hoeken/brineomatic/README.md

This is the hardware design repository for Brineomatic.

For detailed documentation, please visit the [Brineomatic documentation](https://brineomatic.com).
