hoeken/brineomatic/TODO.md

# Rev D

* github action: https://github.com/alphaseneca/kiforge

* component placement
* routing
* silkscreen
* drc checks
* jlc bom check
* place order
