hoeken/brineomatic/(threads)

Thread 1 (2025-09-27):

Hardware alternative. Can`t find the firmware.

pedrogc2, 2025-09-27:
Interesting project. I am working on something similar for myself using the board KC868-A4 which gives most of the functionalities of this hardware and is a cheap Home automation/development board available online. It may be a good alternative instead of develop a specific PCB.
I couldn`t find the firmware code available on this project, is it also opensource?

pedrogc2, 2025-10-02:
Hi,
Thanks to point me to the firmware file and comment on my PCB.
I tried to install the firmware on my board but I was not successful. I am not familiar with PlataformIO so I may be doing something wrong.
First issue was the rpm install that point several vulnerabilities, including 2 critical and uses many deprecated repositories, not sure if it is causing any problem or not. My terminal output attached.
I went forward and install PlataformIO but I had error to compile the file and upload to the board. print attached.

[npm install.txt](https://github.com/user-attachments/files/22653962/npm.install.txt)
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

hoeken, 2025-10-02:
So the main issue here is that ```gulp``` didnt seem to install correctly.  I haven't tried a fresh install of the dev environment in a while, so its possible something has broken.  Gulp is a bit old too, so its possible the build needs to be updated to something more modern.

During the compile process, ```extra_script.py``` is called.  This basically just calls the command ```gulp``` which takes all the html, css, images, etc and compiles it into a single string and writes that to the index.html.gz.h file.  Since gulp isnt working, it can't find that file and so it fails.

Try running gulp from the command line and see what happens.

Once you get that running, the second problem is that you're compiling for the "SENDIT_REV_A" target.  If you want to write for a custom board, you will need to add it to the platformio.ini file and then choose it from the dropdown at the bottom of the window.

If you are interested in helping with development, I'm about to do a new prototype run of the Brineomatic boards and I will have an extra board I could ship to you.
