hoeken/brineomatic/schematics/Brineomatic Rev C1.pdf

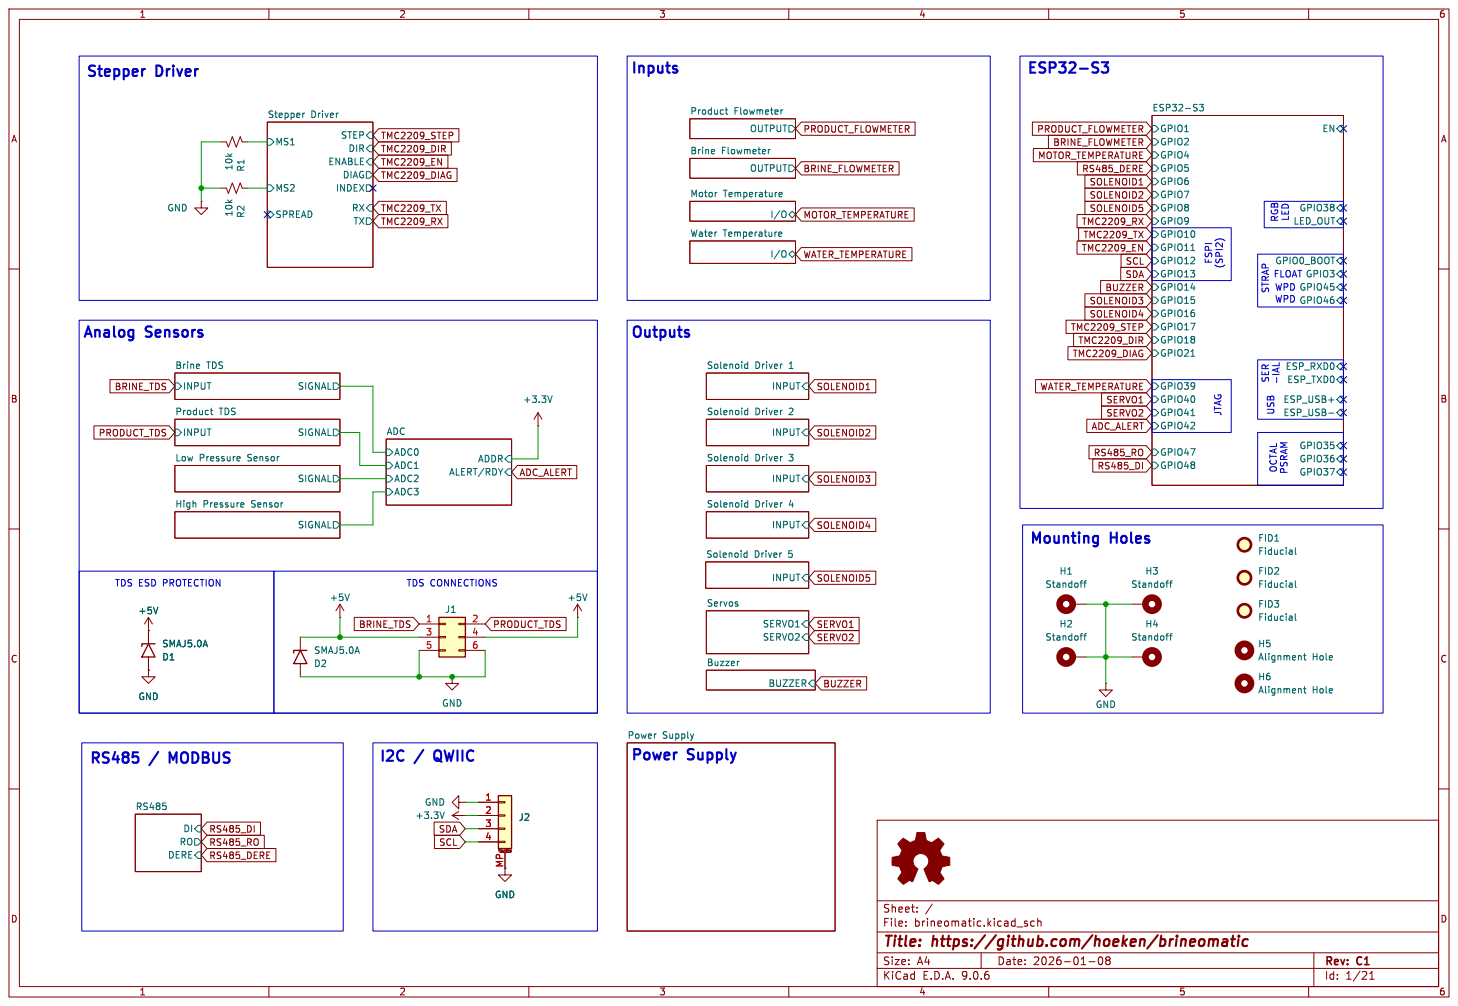
[picture p1: page 1]

SIGNAL High Pressure Sensor

File: brineomatic.kicad_sch Sheet: /
Id: 1/21 Title: https://github.com/hoeken/brineomatic

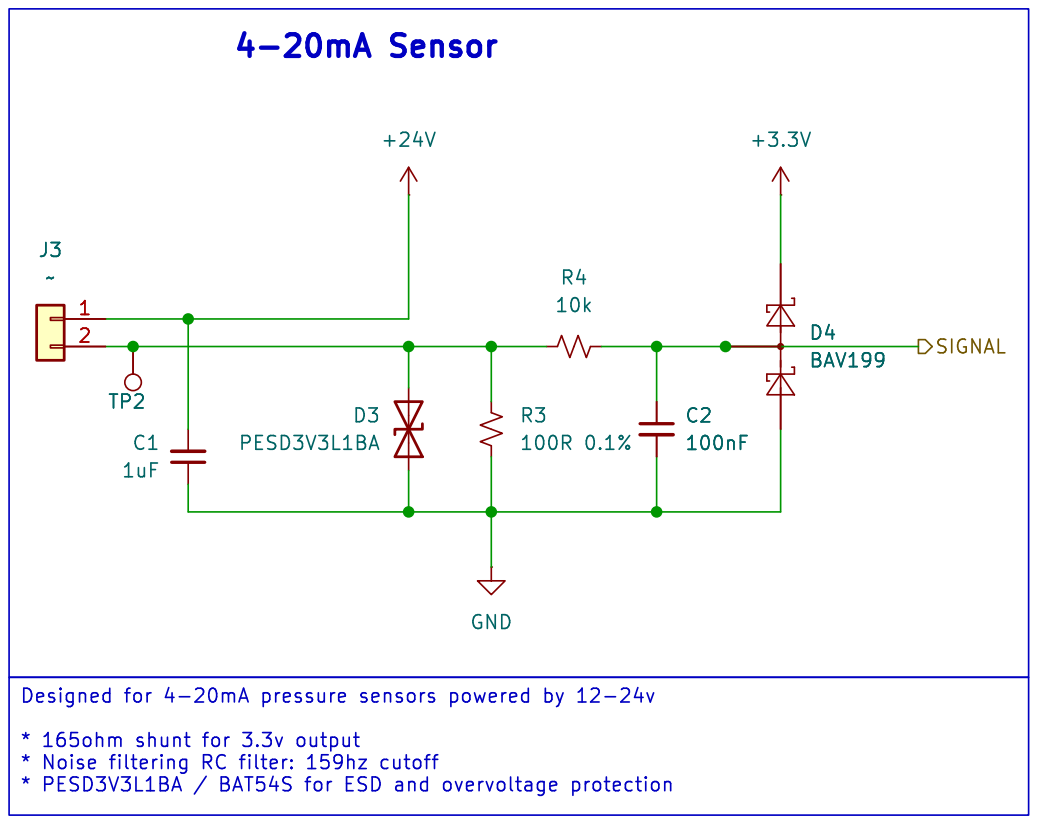
[picture p2: page 2]

Id: 2/21 Title: https://github.com/hoeken/brineomatic

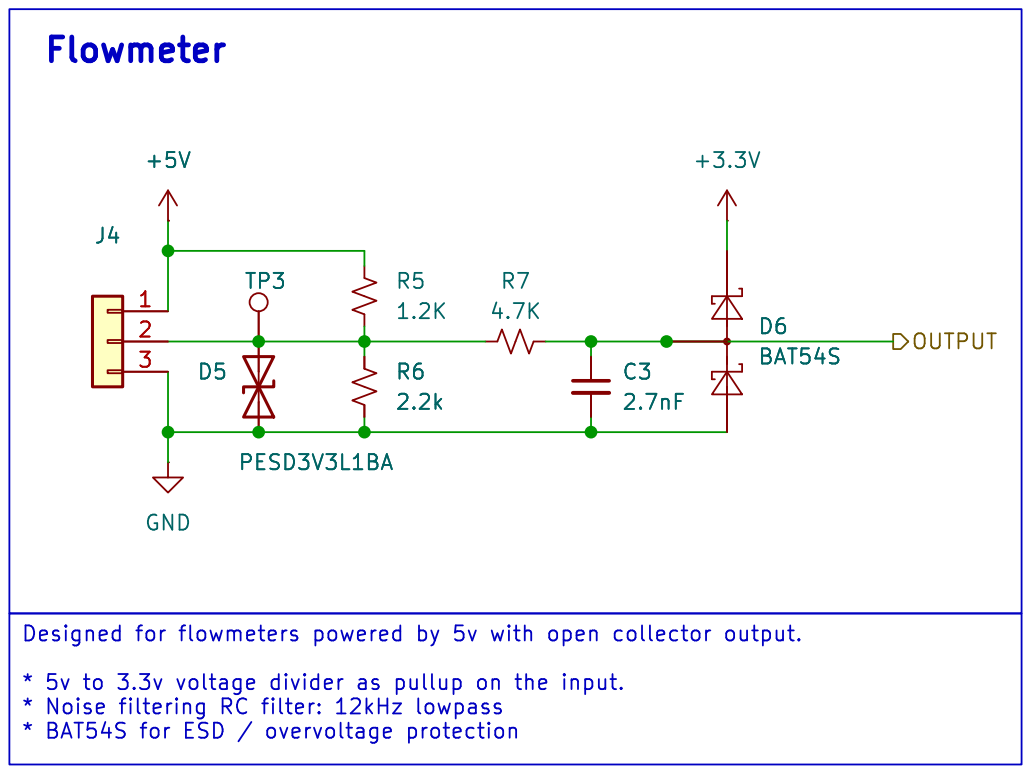
[picture p3: page 3]

Id: 3/21 Title: https://github.com/hoeken/brineomatic

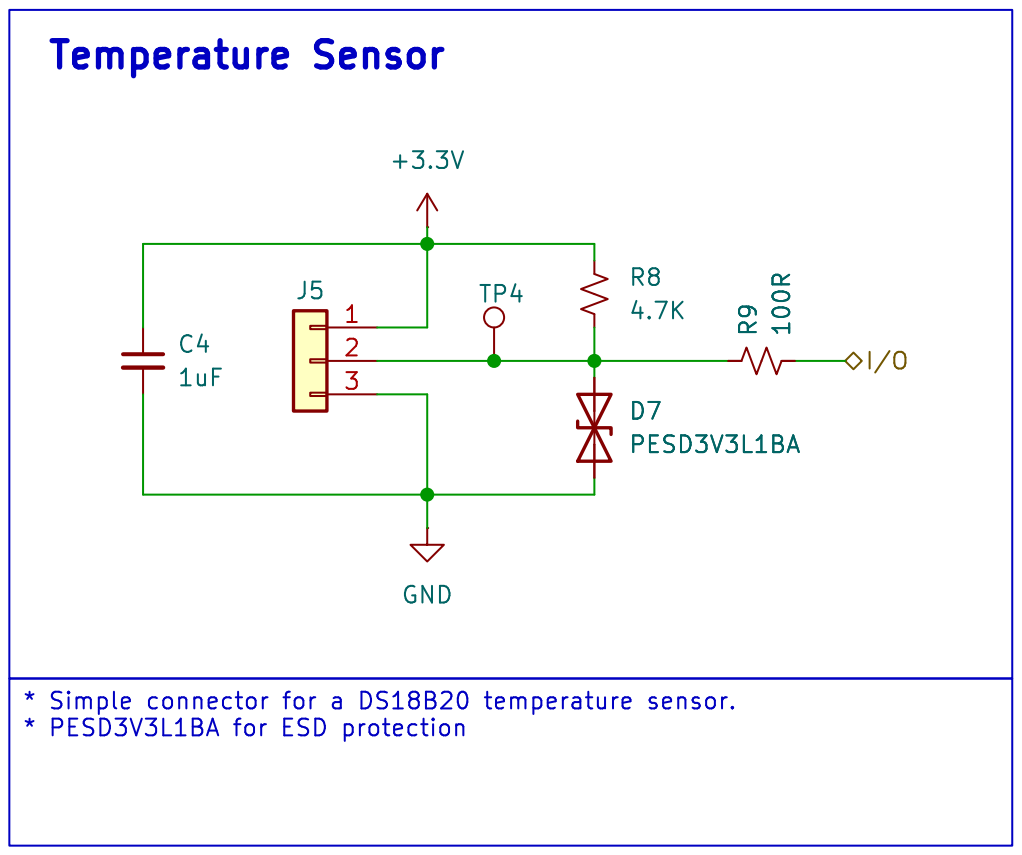
[picture p4: page 4]

Id: 4/21 Title: https://github.com/hoeken/brineomatic

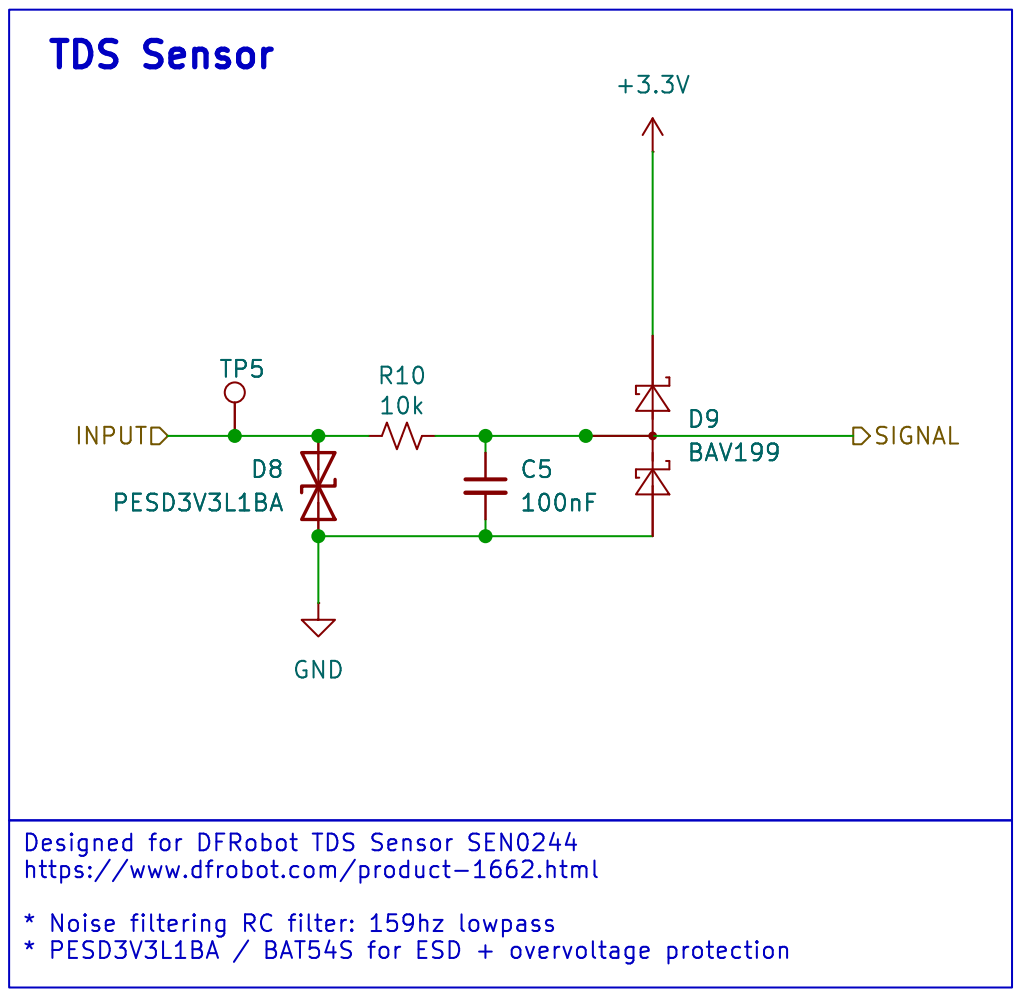
[picture p5: page 5]

Id: 5/21 Title: https://github.com/hoeken/brineomatic

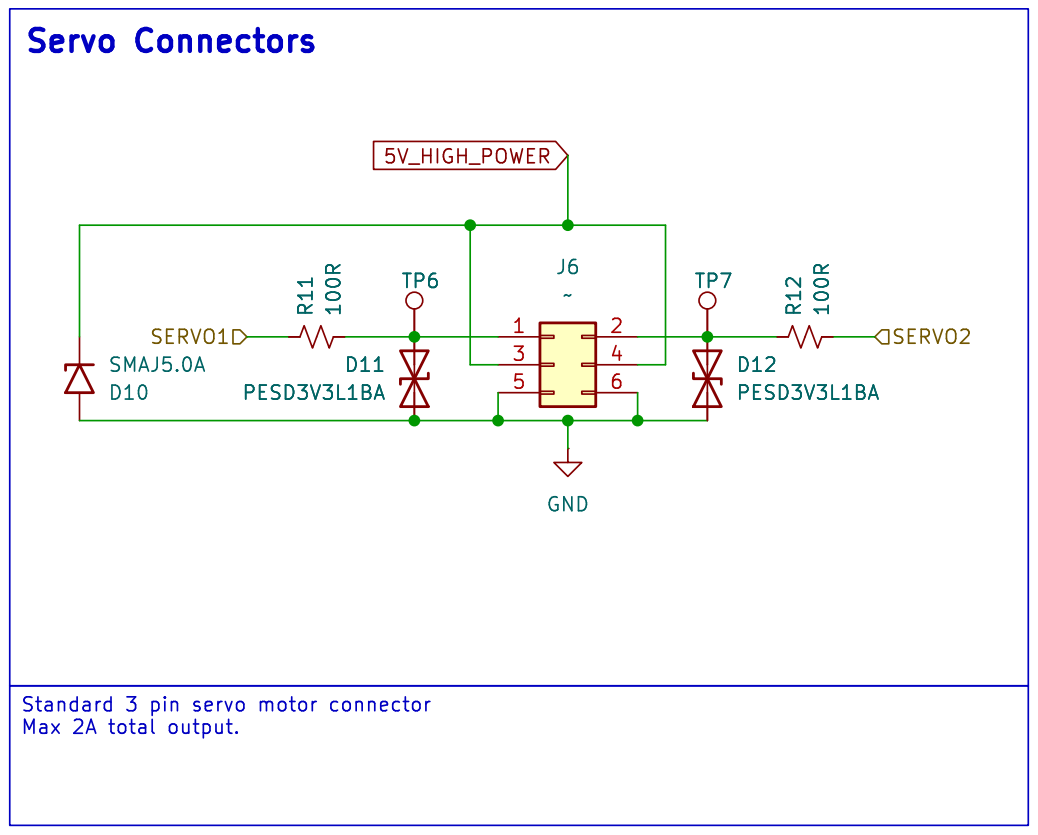
[picture p6: page 6]

Standard 3 pin servo motor connector Max 2A total output. Servo Connectors
File: servo.kicad_sch Sheet: /Servos/ R12 100R

Id: 6/21 Title: https://github.com/hoeken/brineomatic

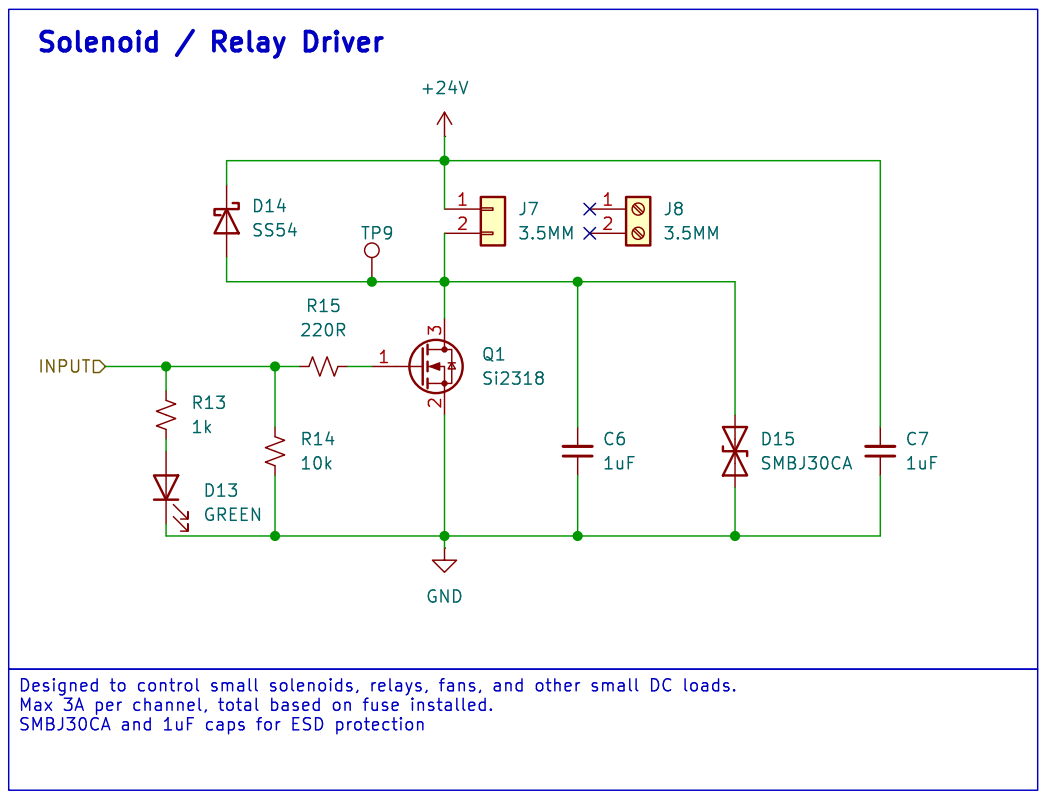
[picture p7: page 7]

Id: 7/21 Title: https://github.com/hoeken/brineomatic

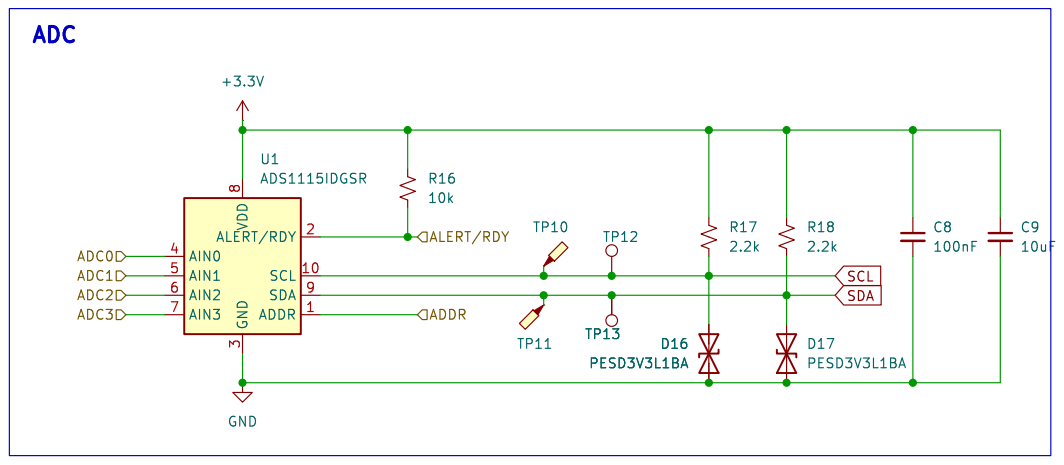
[picture p8: page 8]

3 ALERT/RDY 2 SCL 10 SDA 9 ADDR 1 U1ADS1115IDGSR

Id: 8/21 Title: https://github.com/hoeken/brineomatic

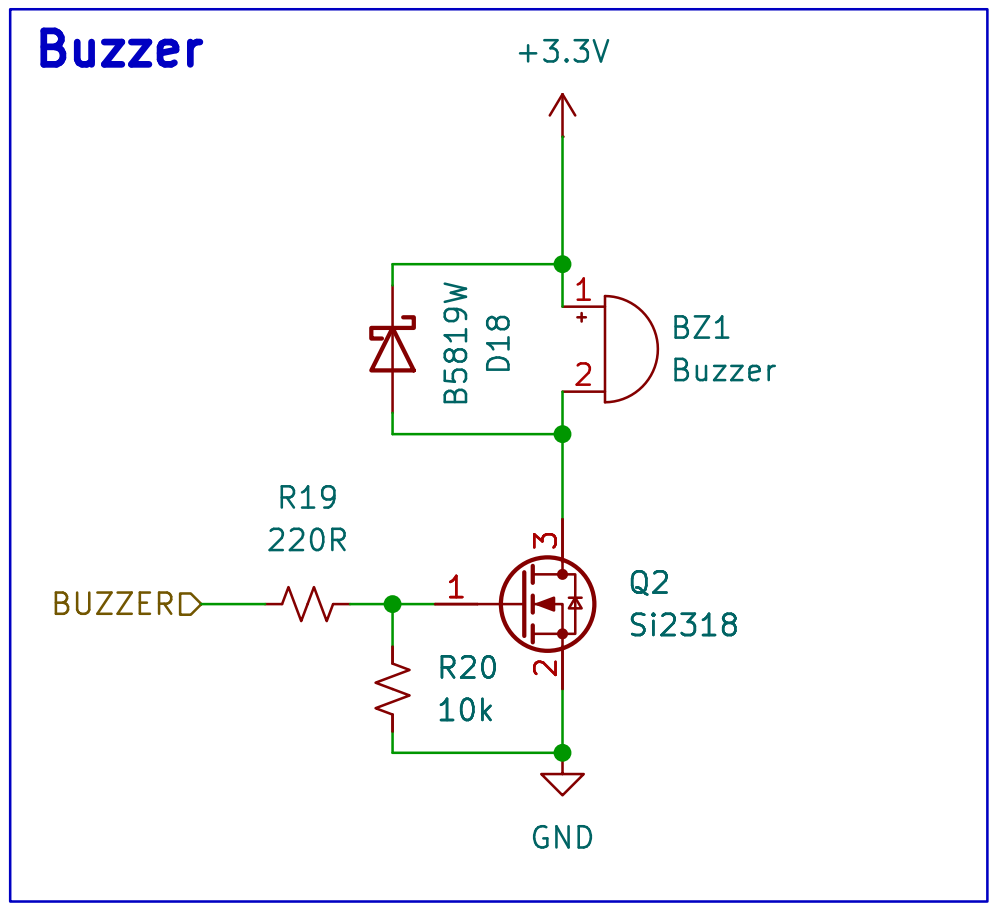
[picture p9: page 9]

File: piezo.kicad_sch Sheet: /Buzzer/ R20

Id: 9/21 Title: https://github.com/hoeken/brineomatic

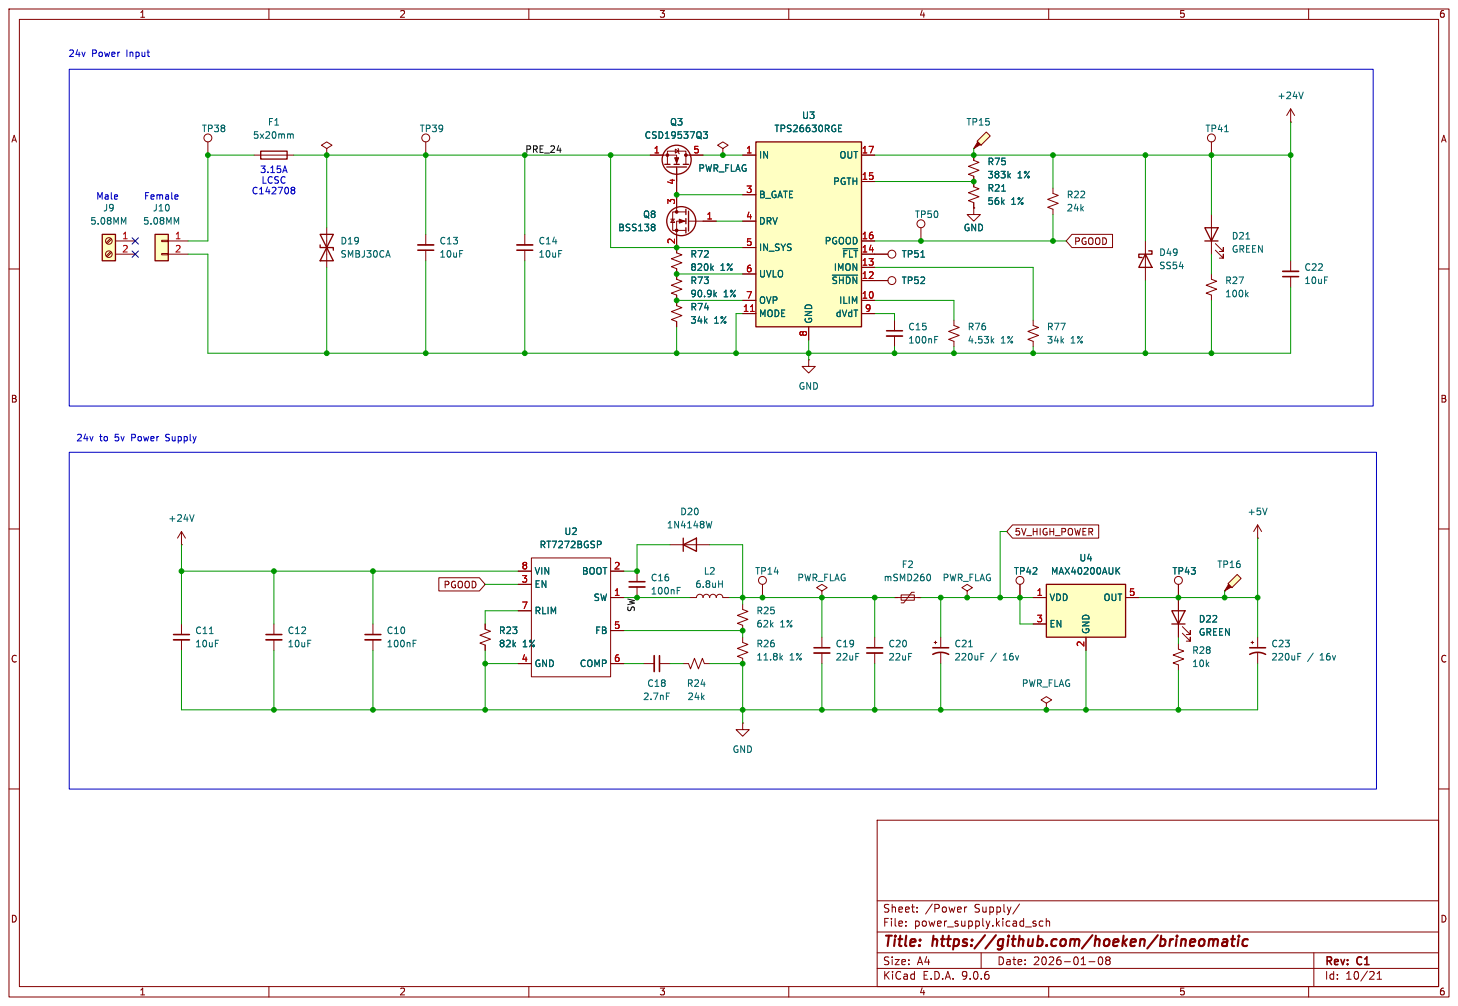
[picture p10: page 10]

8 OUT 17 PGTH 15 PGOOD 16 ~{FLT} 14

3 2 Q8 BSS138 VIN 8 EN 3 RLIM 7 GND 4 BOOT 2 SW 1 FB 5 COMP 6 U2 RT7272BGSP C18

Id: 10/21 Title: https://github.com/hoeken/brineomatic

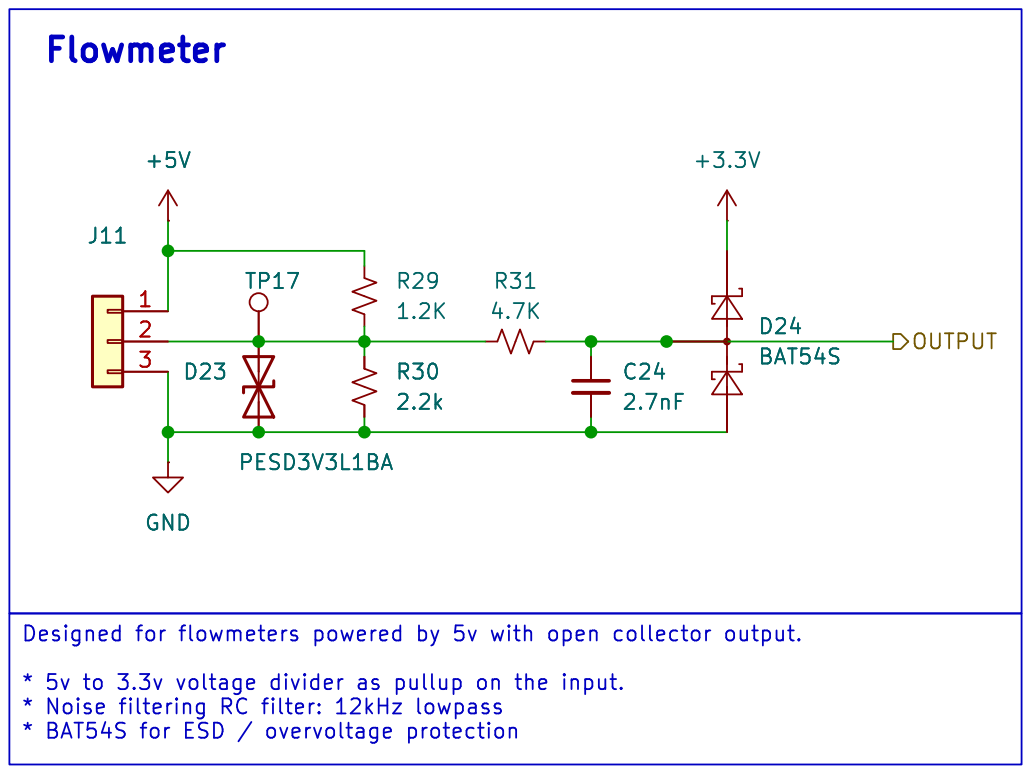
[picture p11: page 11]

Id: 11/21 Title: https://github.com/hoeken/brineomatic

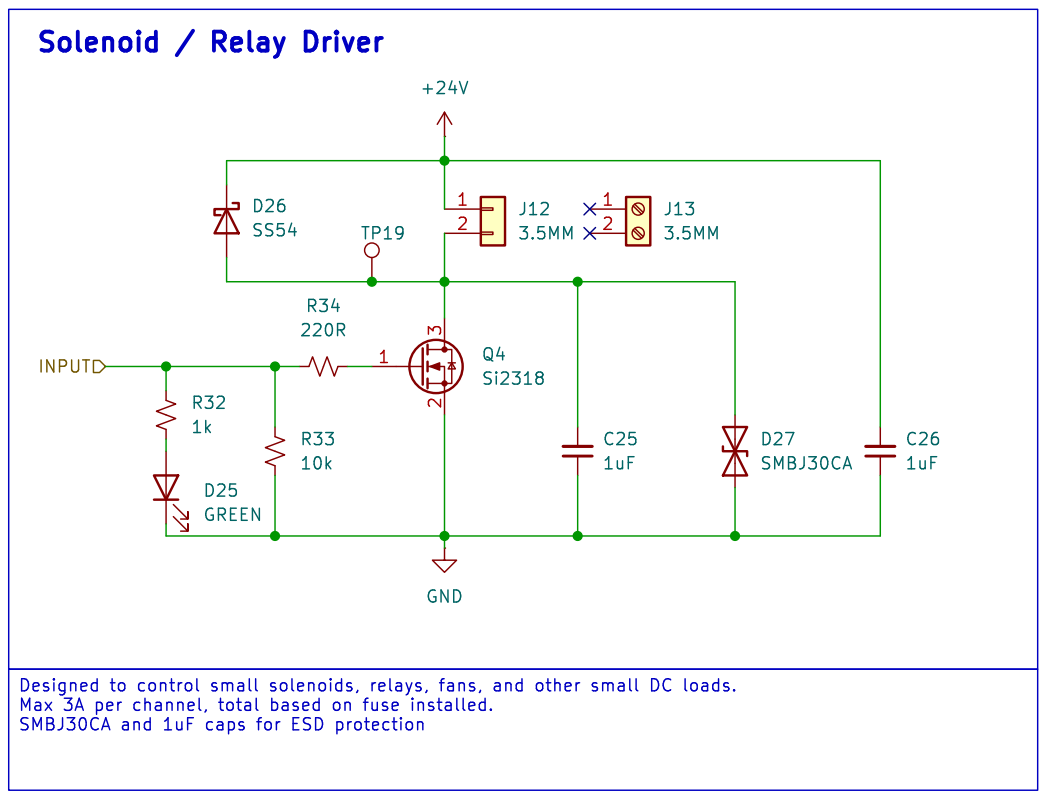
[picture p12: page 12]

Id: 12/21 Title: https://github.com/hoeken/brineomatic

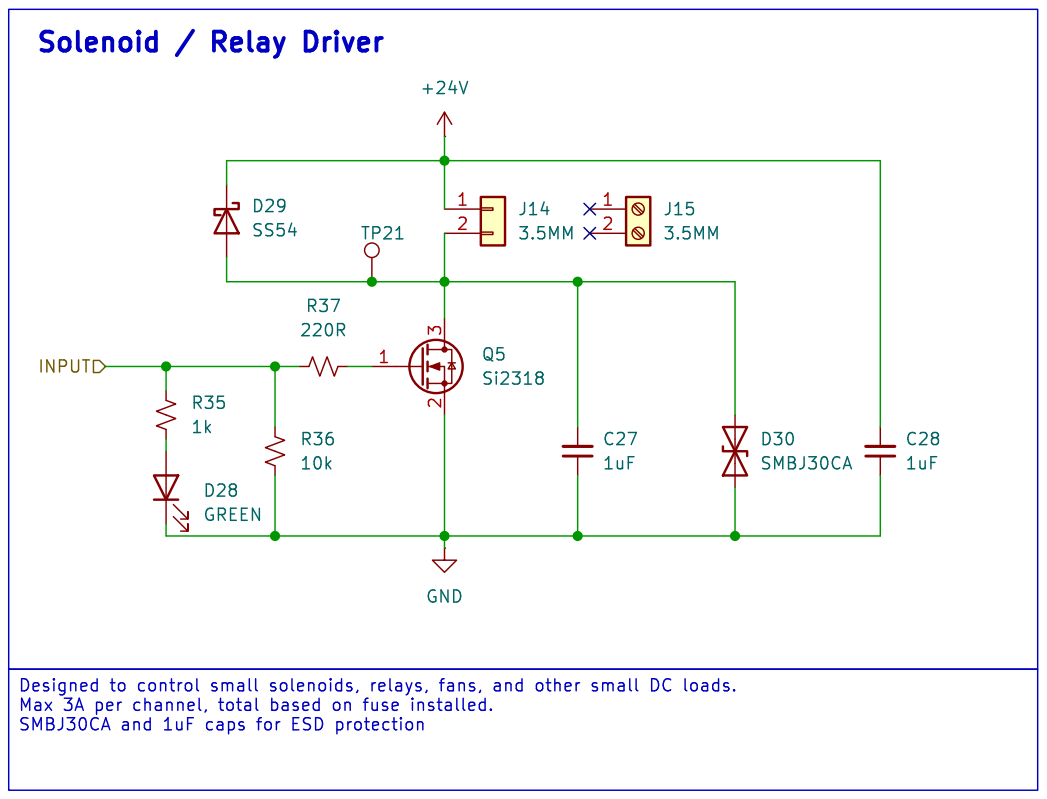
[picture p13: page 13]

Id: 13/21 Title: https://github.com/hoeken/brineomatic

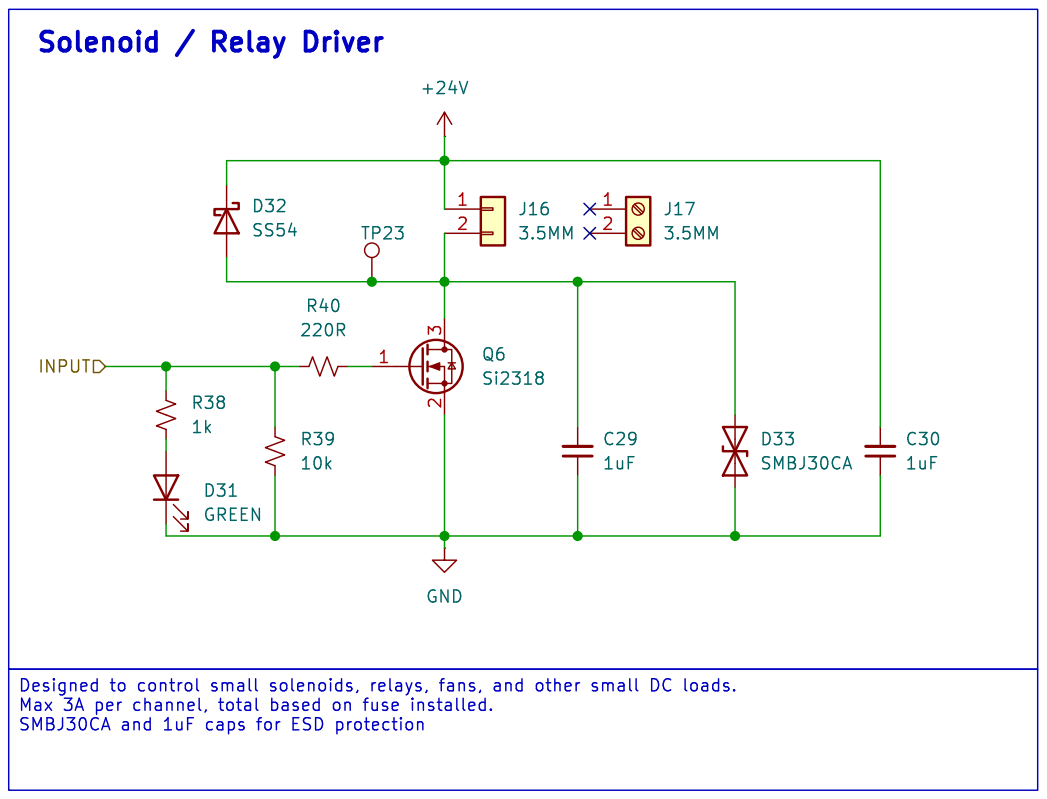
[picture p14: page 14]

Id: 14/21 Title: https://github.com/hoeken/brineomatic

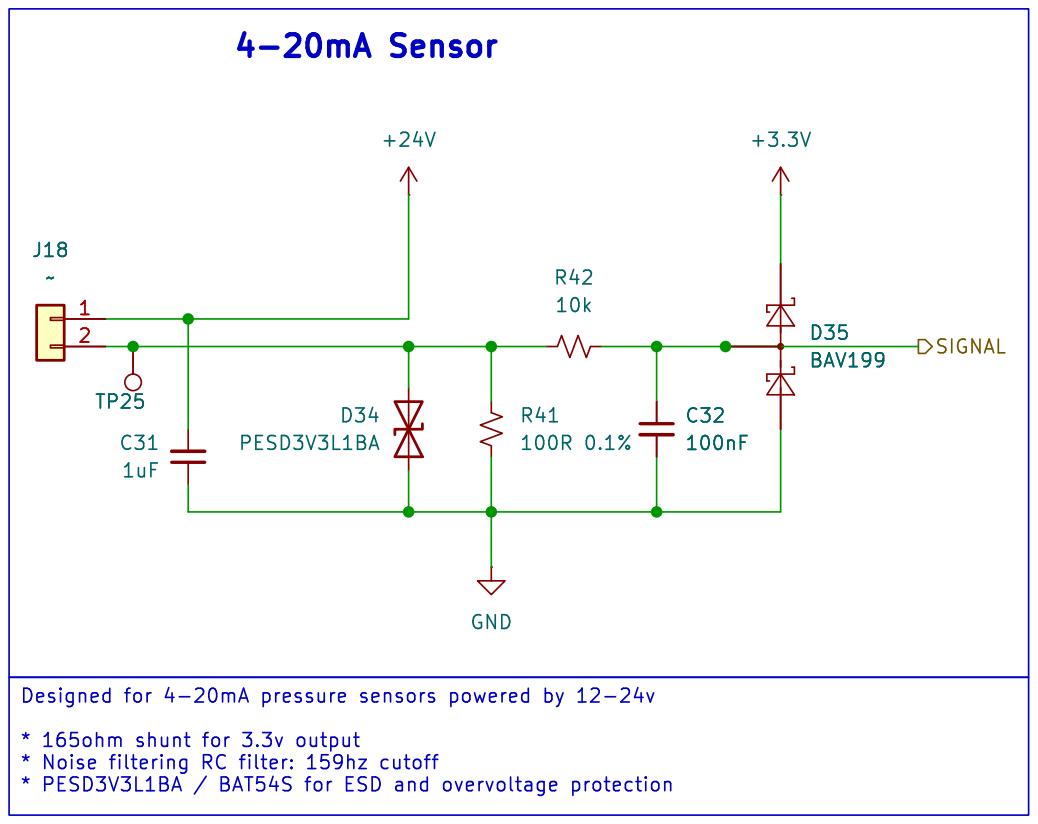
[picture p15: page 15]

Id: 15/21 Title: https://github.com/hoeken/brineomatic

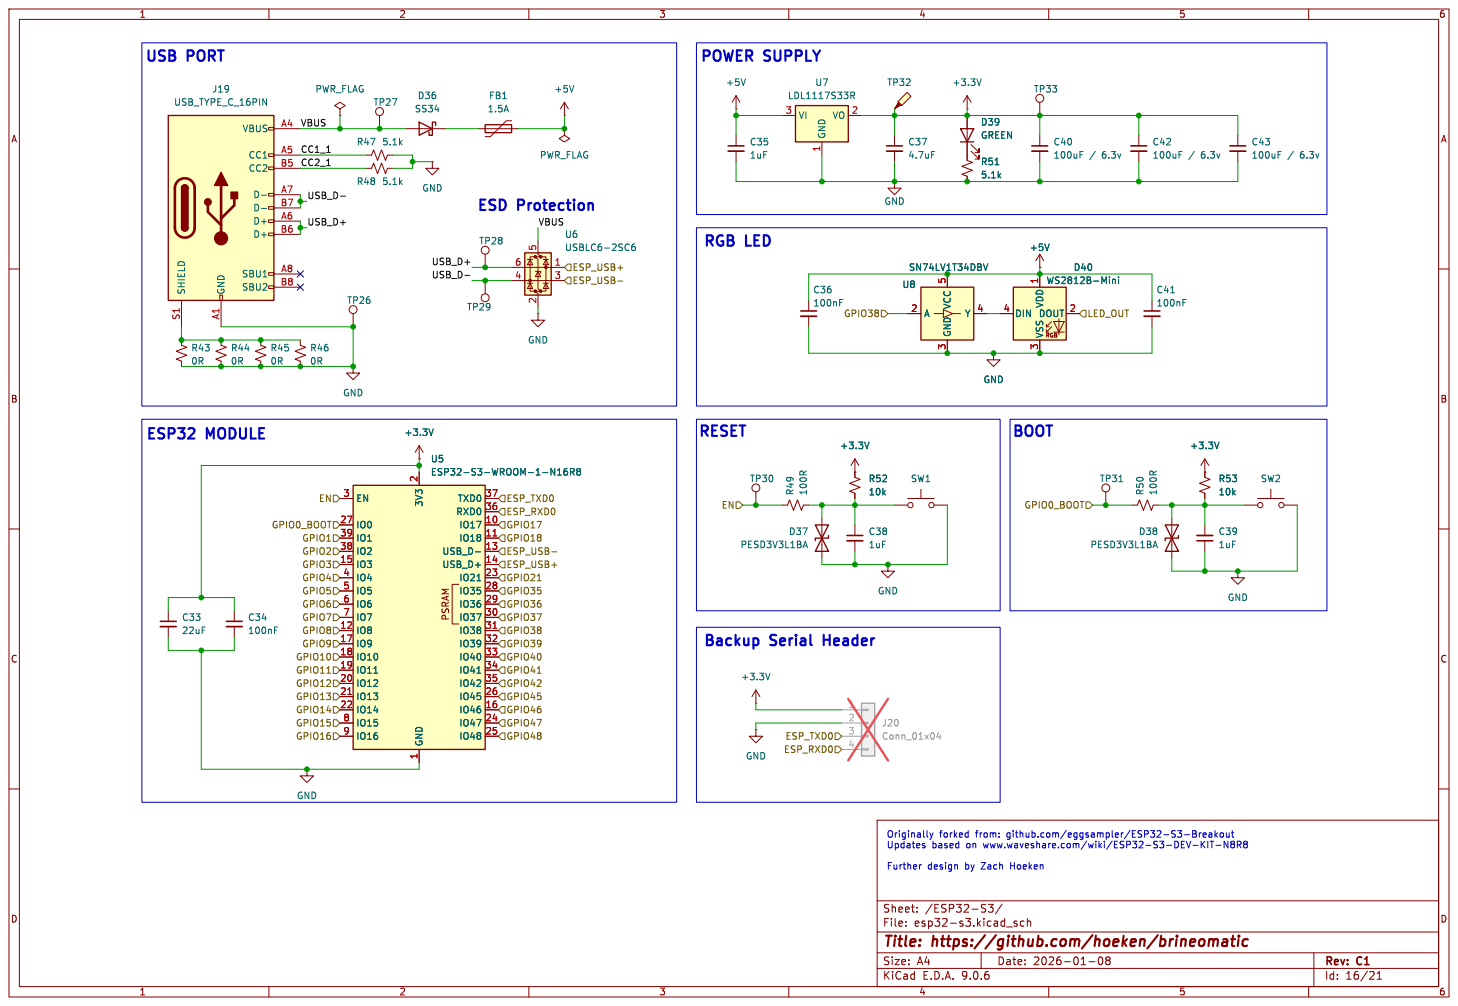
[picture p16: page 16]

Updates based on www.waveshare.com/wiki/ESP32-S3-DEV-KIT-N8R8 Further design by Zach Hoeken BOOT

File: esp32-s3.kicad_sch Sheet: /ESP32-S3/
Id: 16/21 Title: https://github.com/hoeken/brineomatic

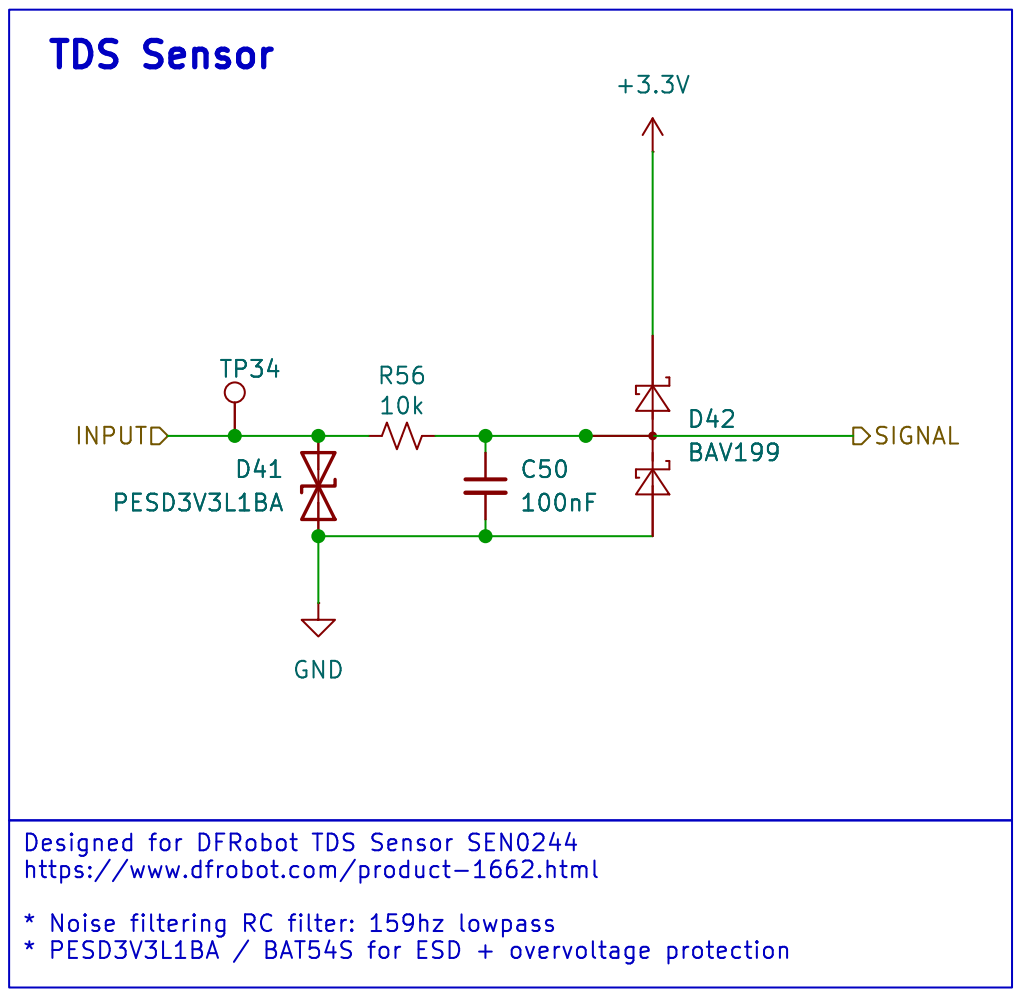
[picture p17: page 17]

Id: 17/21 Title: https://github.com/hoeken/brineomatic

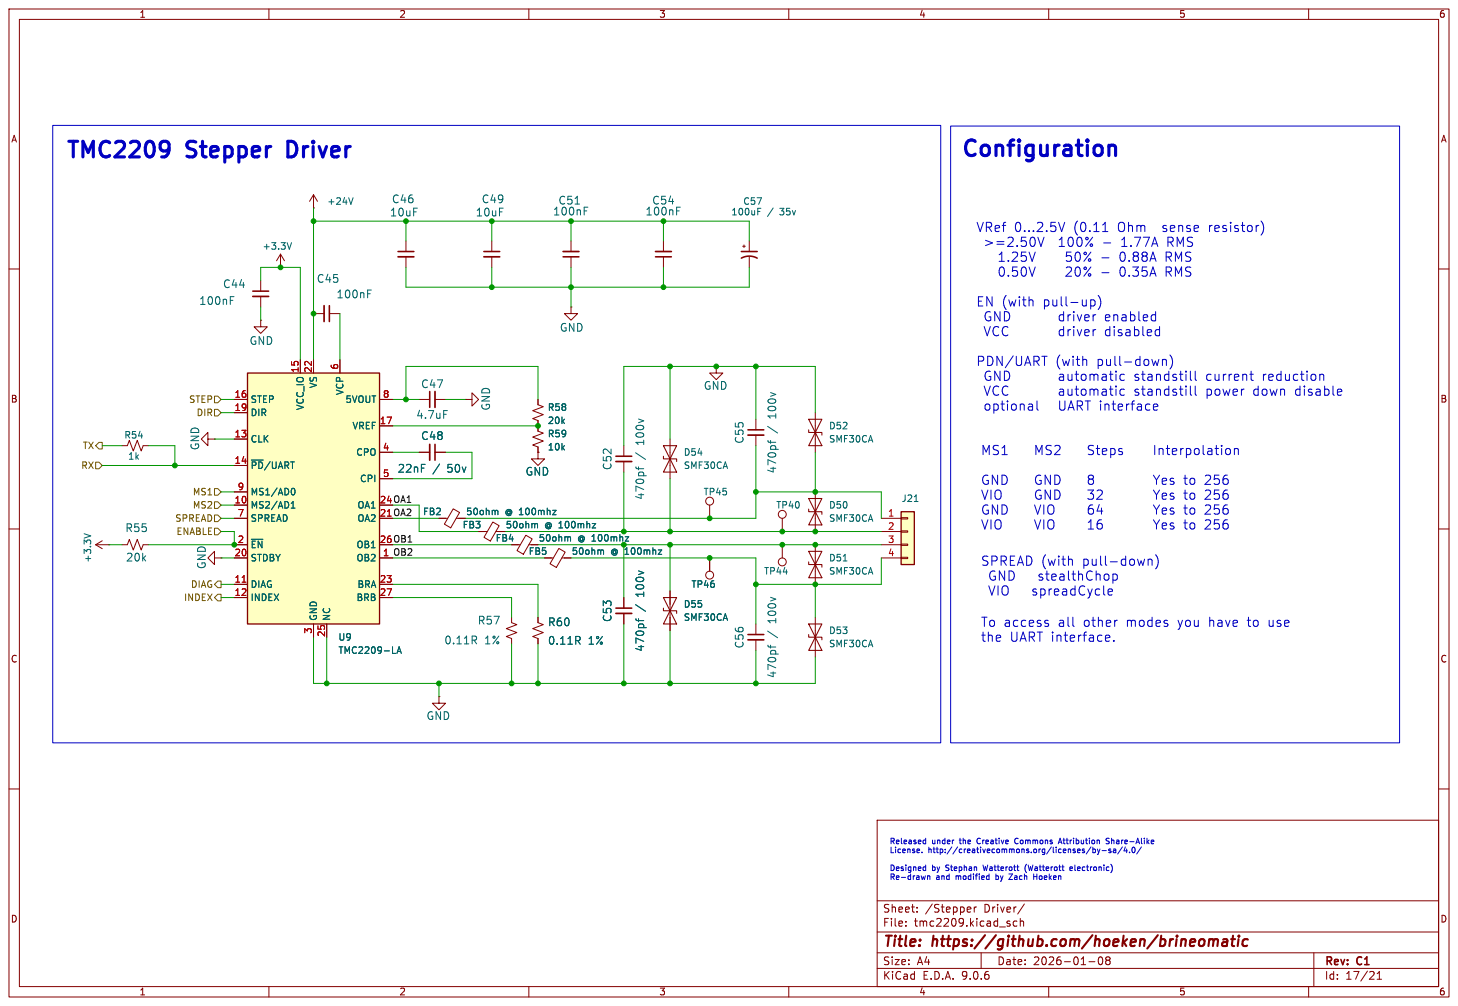
[picture p18: page 18]

EN (with pull-up)
GND
VCC

PDN/UART (with pull-down)

SPREAD (with pull-down)

To access all other modes you have to use
the UART interface.

Id: 17/21 Title: https://github.com/hoeken/brineomatic

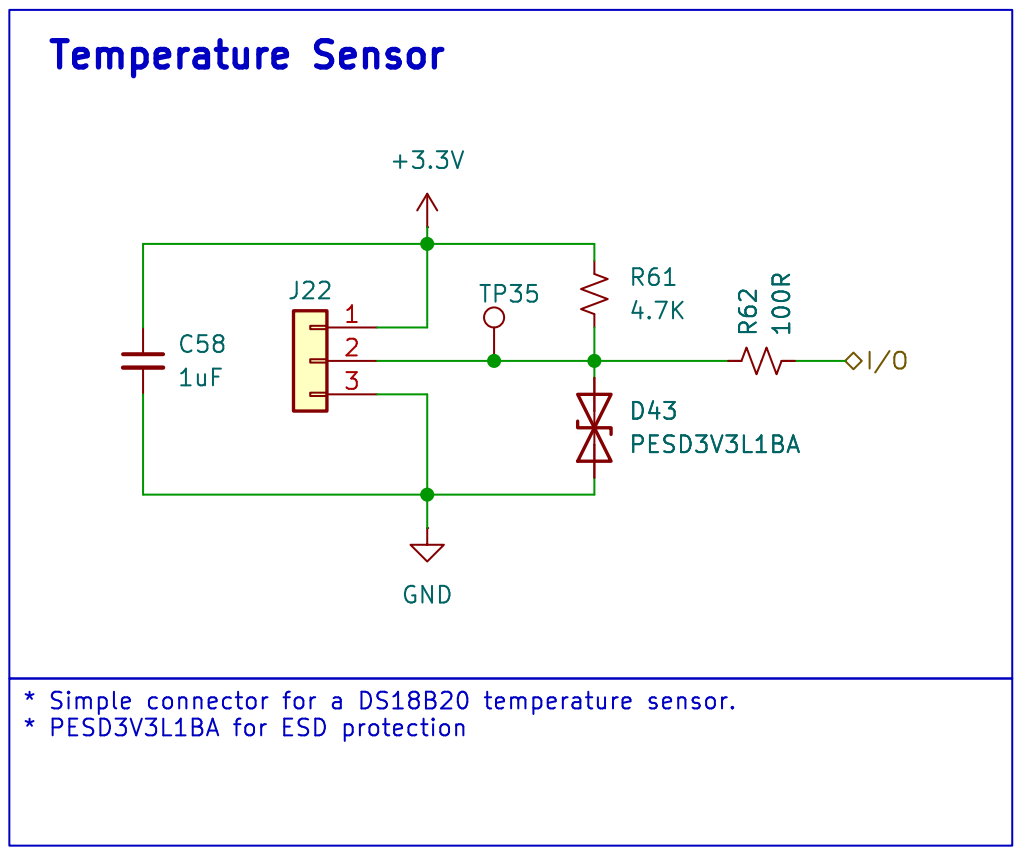
[picture p19: page 19]

Id: 18/21 Title: https://github.com/hoeken/brineomatic

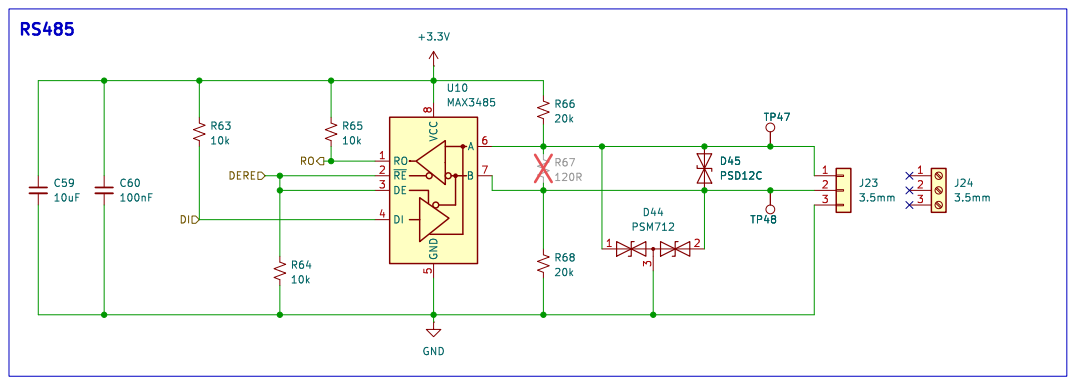
[picture p20: page 20]

File: rs485.kicad_sch Sheet: /RS485/
Id: 19/21 Title: https://github.com/hoeken/brineomatic

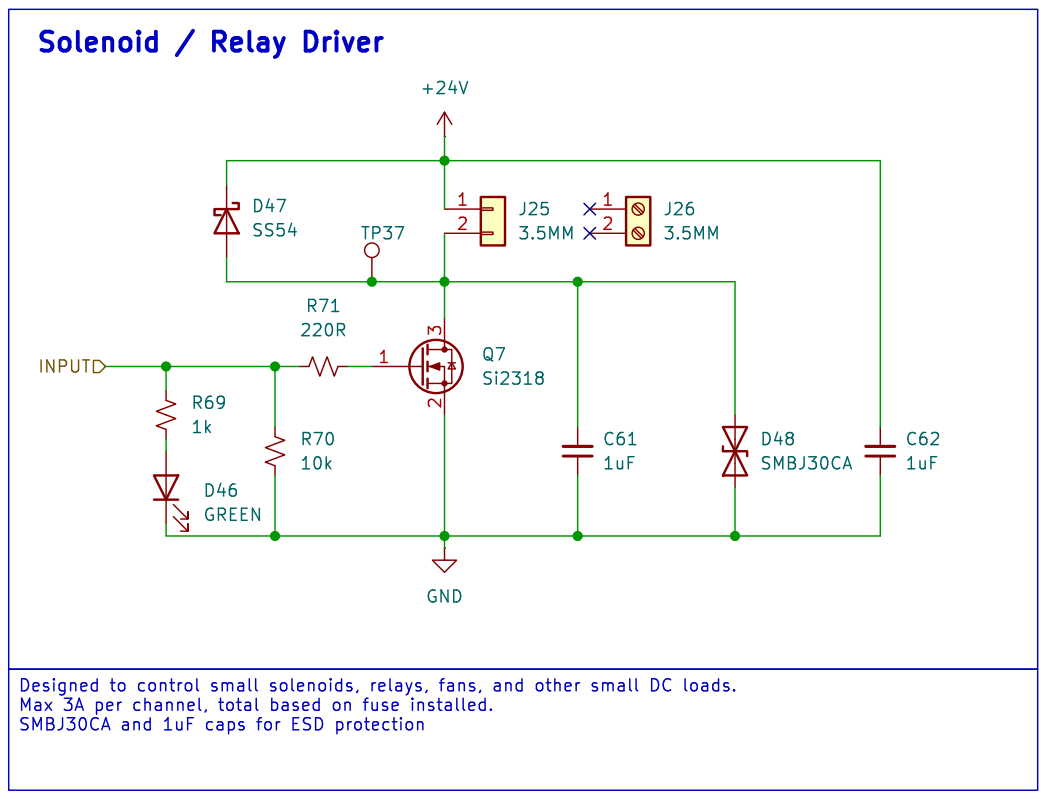
[picture p21: page 21]

Id: 20/21 Title: https://github.com/hoeken/brineomatic
