hoeken/brineomatic/schematics/Brineomatic Rev B.pdf

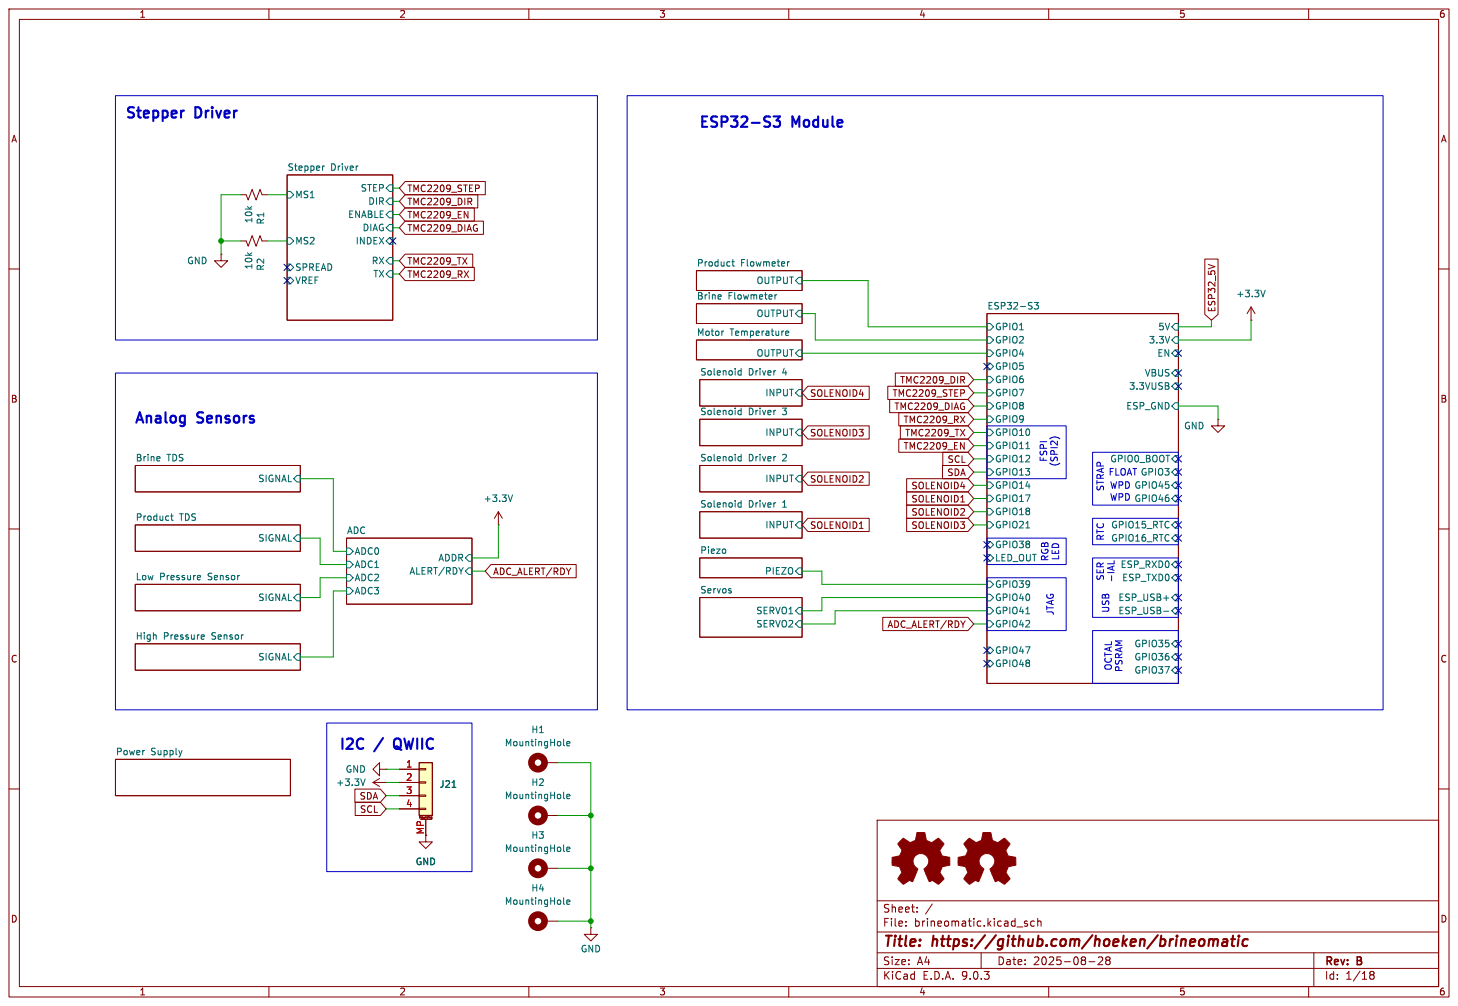
[picture p22: page 1]

STEP
INPUT Solenoid Driver 3 DIR
ENABLE

Piezo SIGNAL Brine TDS

INPUT Solenoid Driver 2 PIEZO

File: brineomatic.kicad_sch Sheet: /
Id: 1/18 Title: https://github.com/hoeken/brineomatic

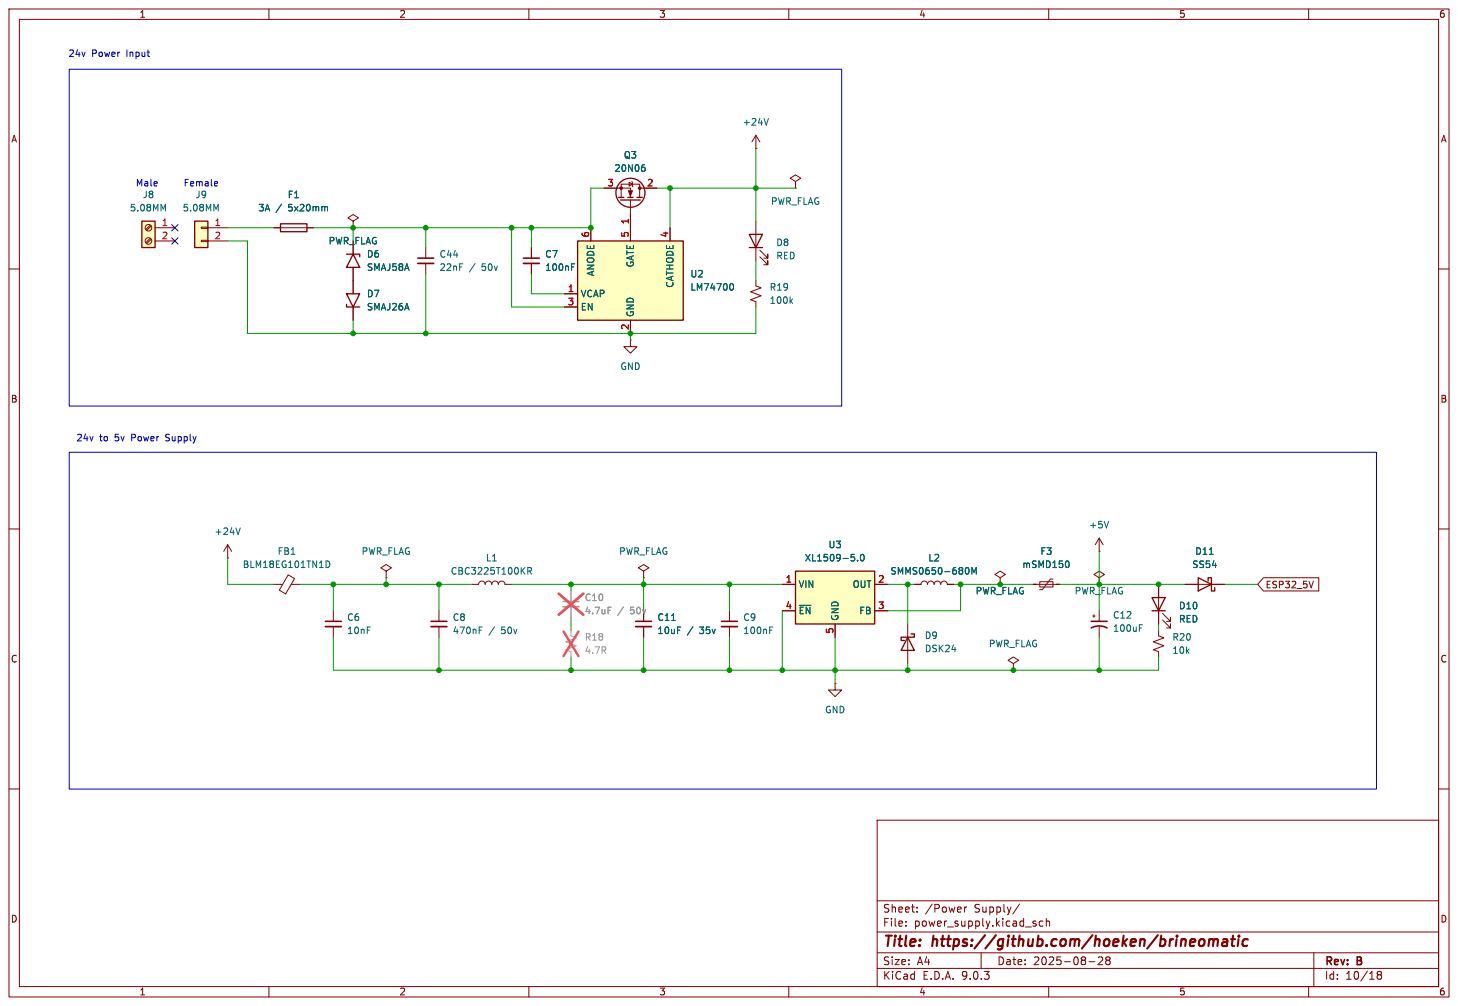
[picture p23: page 2]

Id: 10/18 Title: https://github.com/hoeken/brineomatic

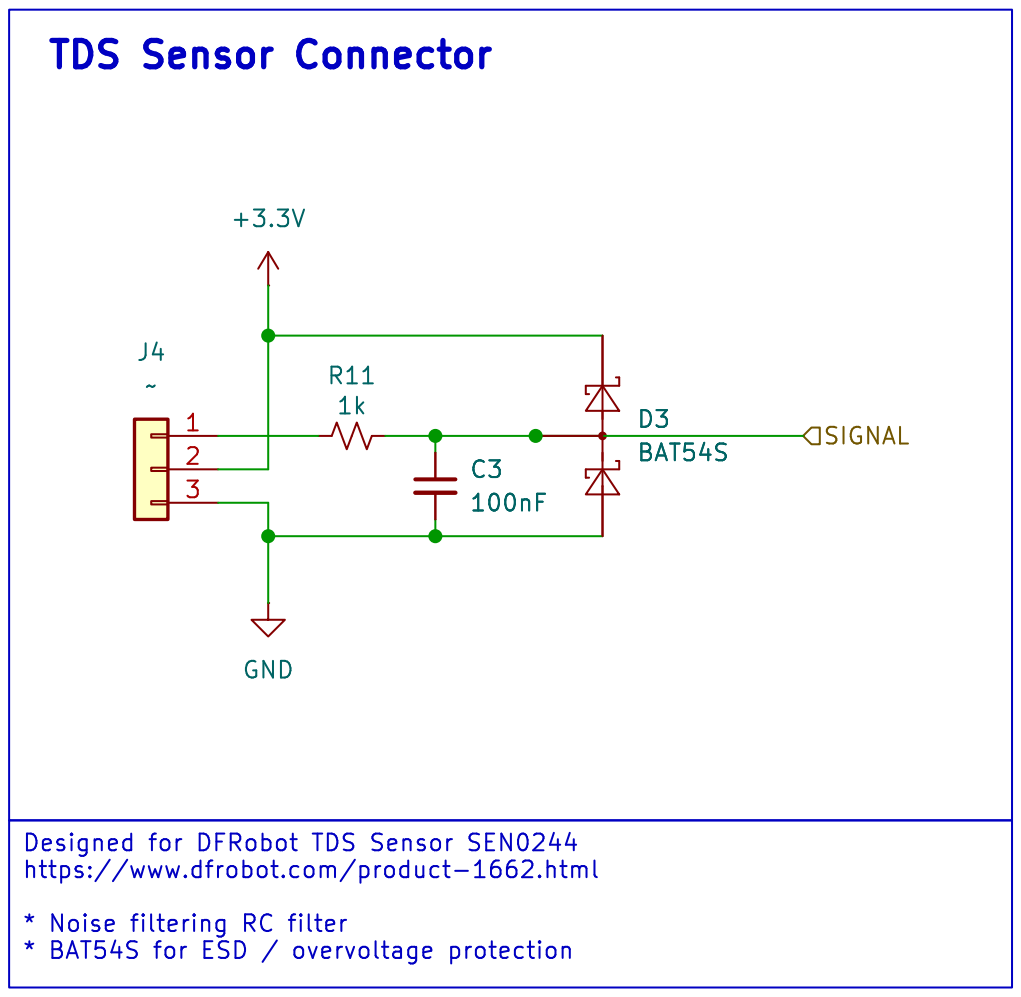
[picture p24: page 3]

SIGNAL Designed for DFRobot TDS Sensor SEN0244

Id: 5/18 Title: https://github.com/hoeken/brineomatic

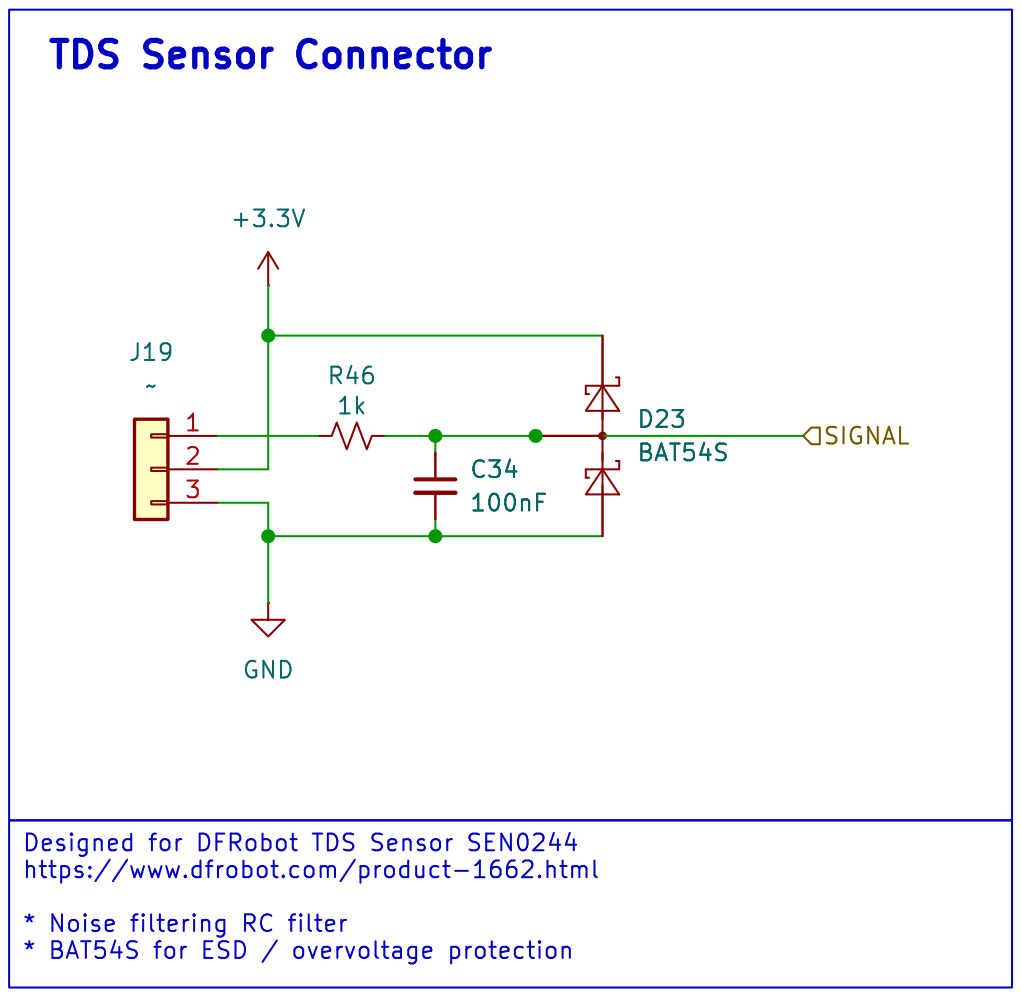
[picture p25: page 4]

SIGNAL Designed for DFRobot TDS Sensor SEN0244

Id: 17/18 Title: https://github.com/hoeken/brineomatic

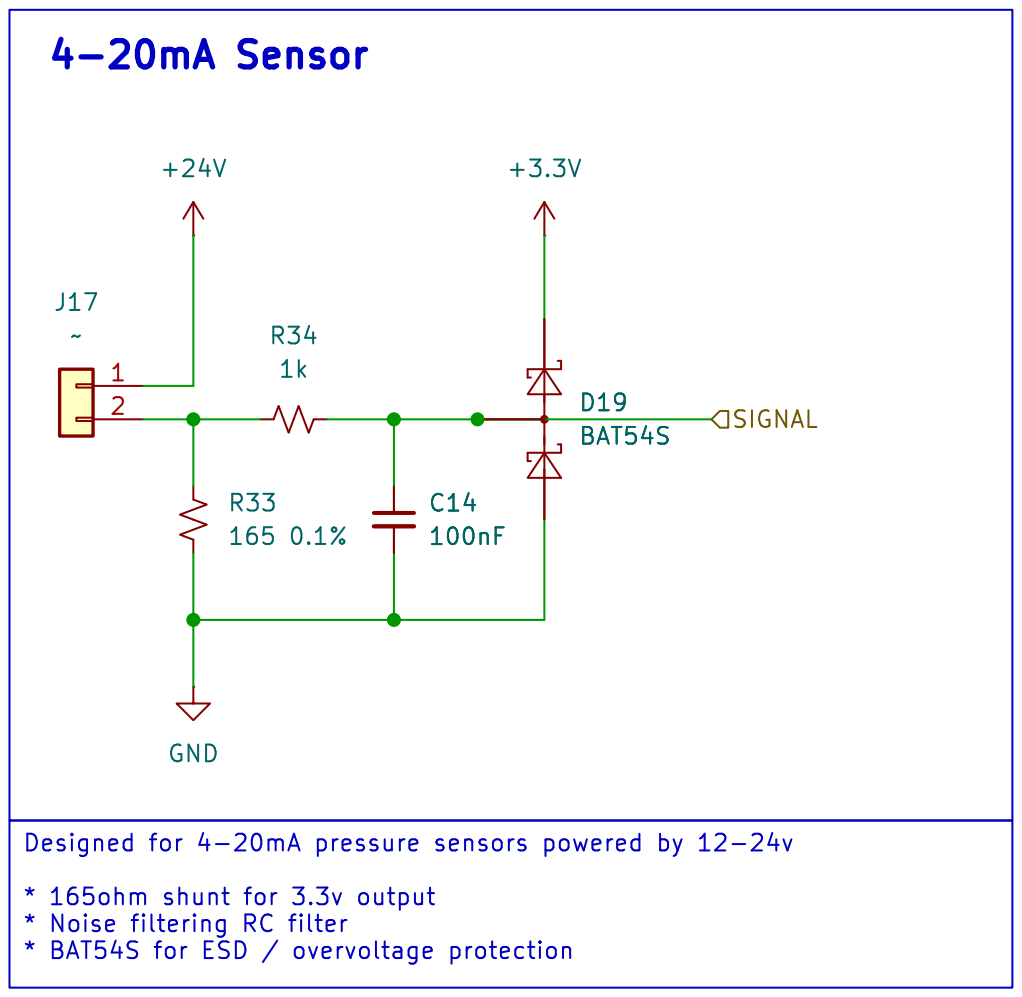
[picture p26: page 5]

Id: 15/18 Title: https://github.com/hoeken/brineomatic

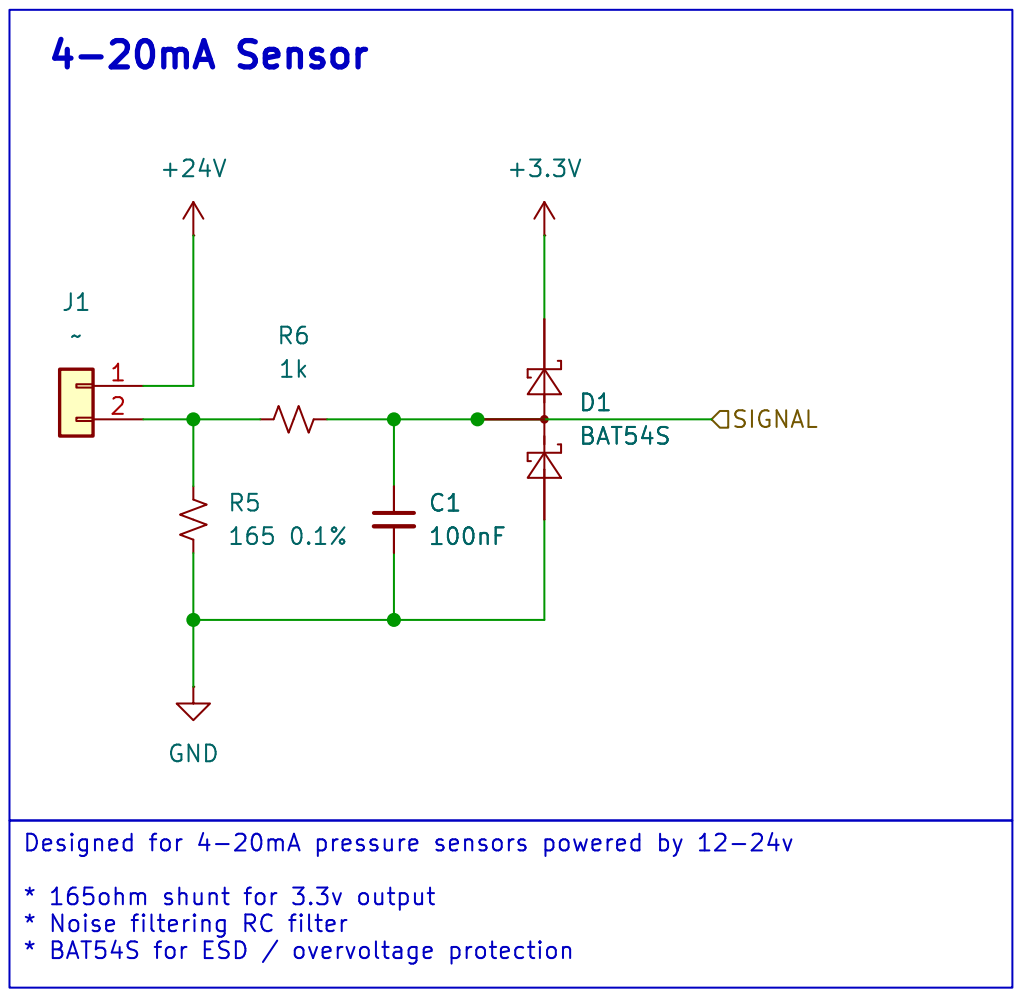
[picture p27: page 6]

Id: 2/18 Title: https://github.com/hoeken/brineomatic

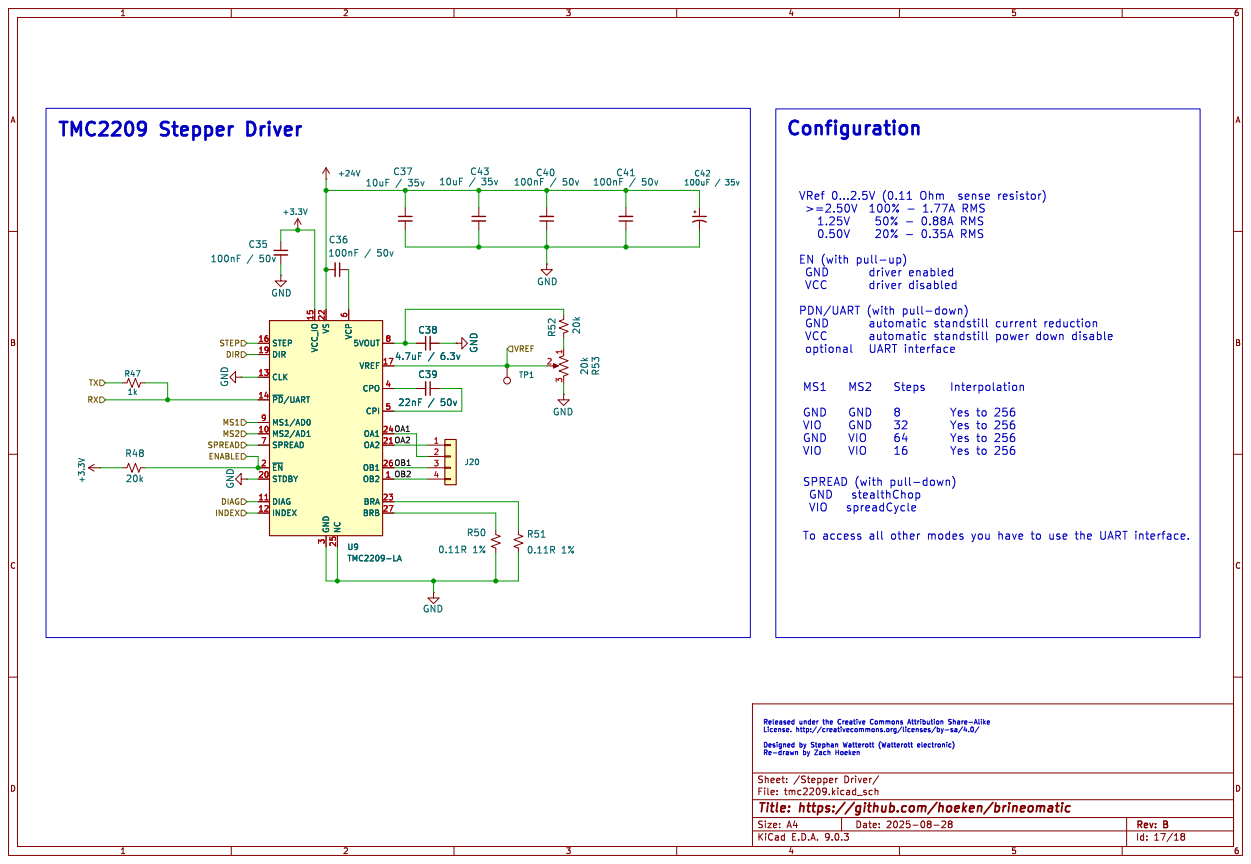
[picture p28: page 7]

EN (with pull-up)
GND
VCC

PDN/UART (with pull-down)

SPREAD (with pull-down)

To access all other modes you have to use the UART interface.

Id: 17/18 Title: https://github.com/hoeken/brineomatic

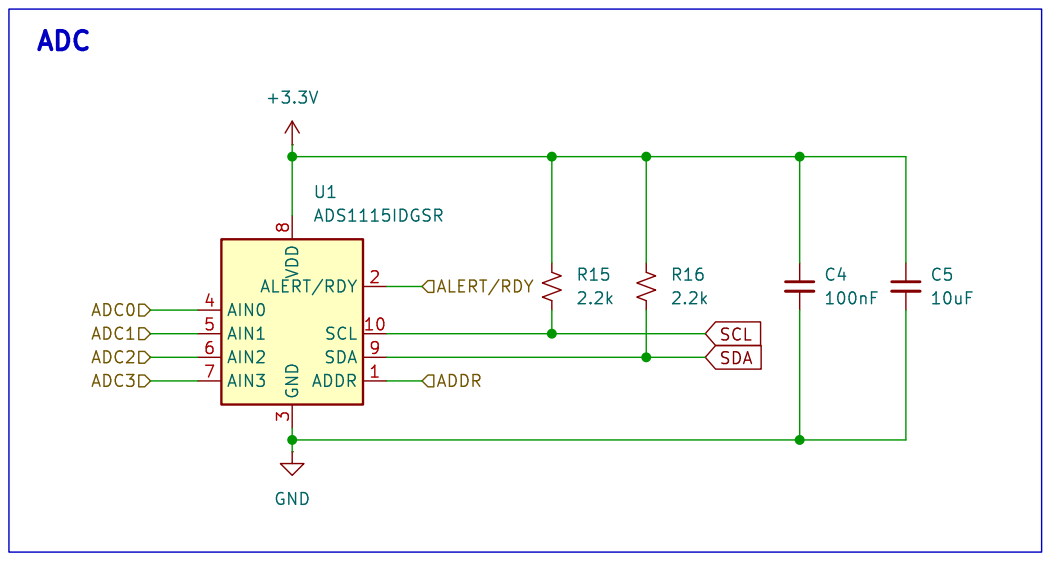
[picture p29: page 8]

3 ALERT/RDY 2 SCL 10 SDA 9 ADDR 1 U1ADS1115IDGSR

File: 1115_adc.kicad_sch Sheet: /ADC/
Id: 8/18 Title: https://github.com/hoeken/brineomatic

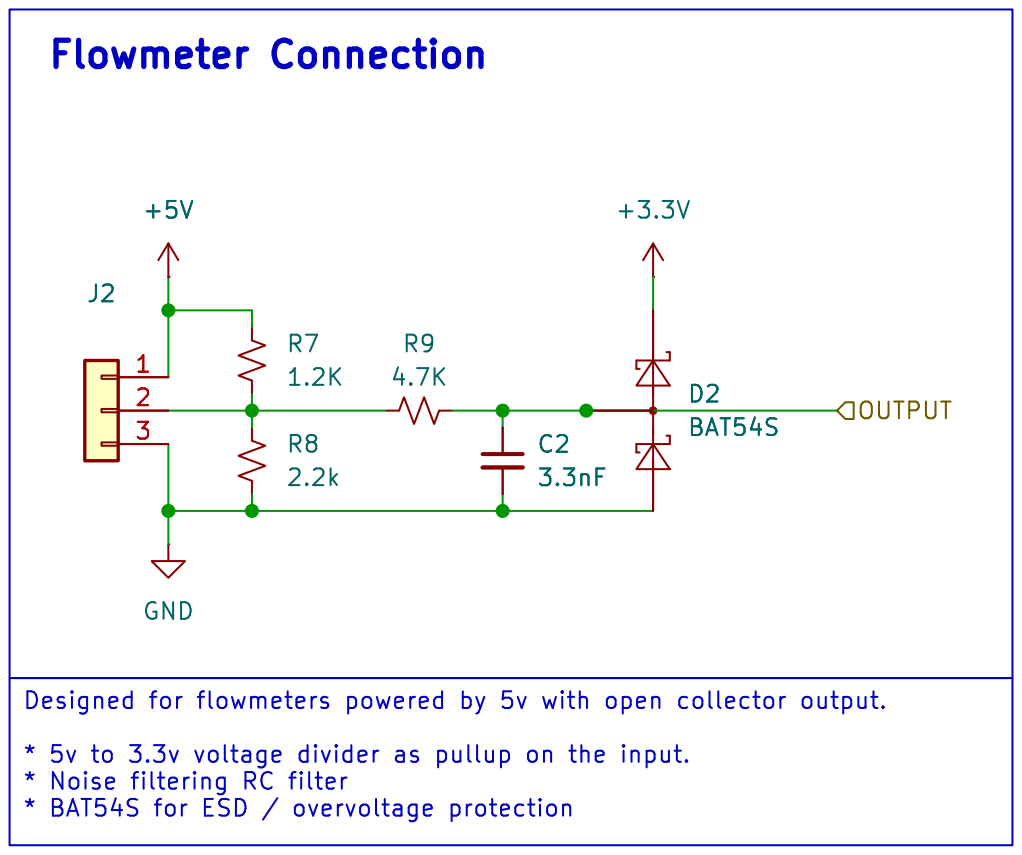
[picture p30: page 9]

Id: 3/18 Title: https://github.com/hoeken/brineomatic

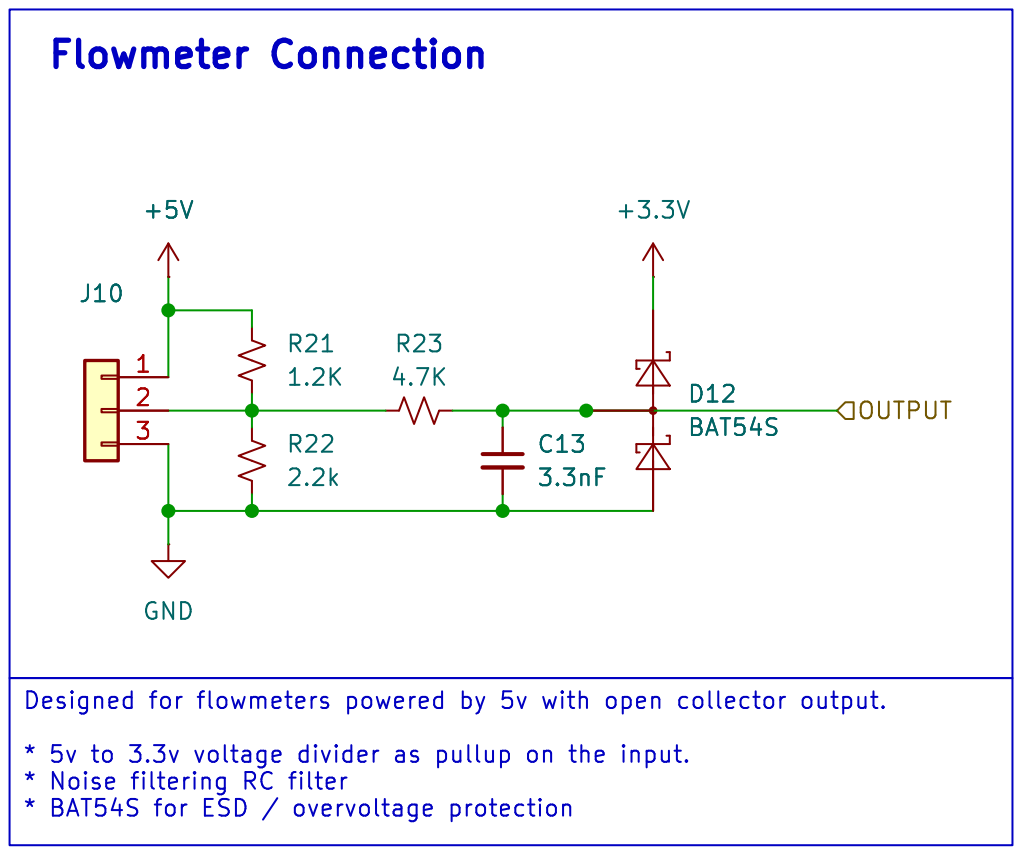
[picture p31: page 10]

Id: 11/18 Title: https://github.com/hoeken/brineomatic

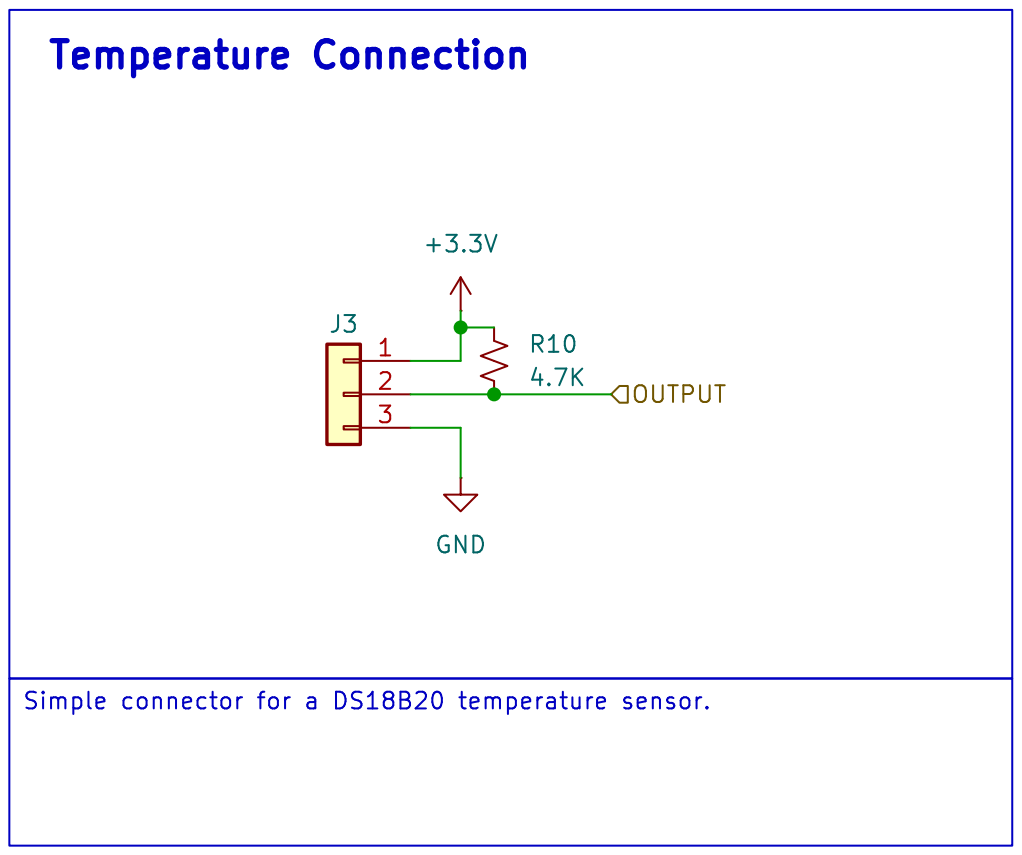
[picture p32: page 11]

Id: 4/18 Title: https://github.com/hoeken/brineomatic

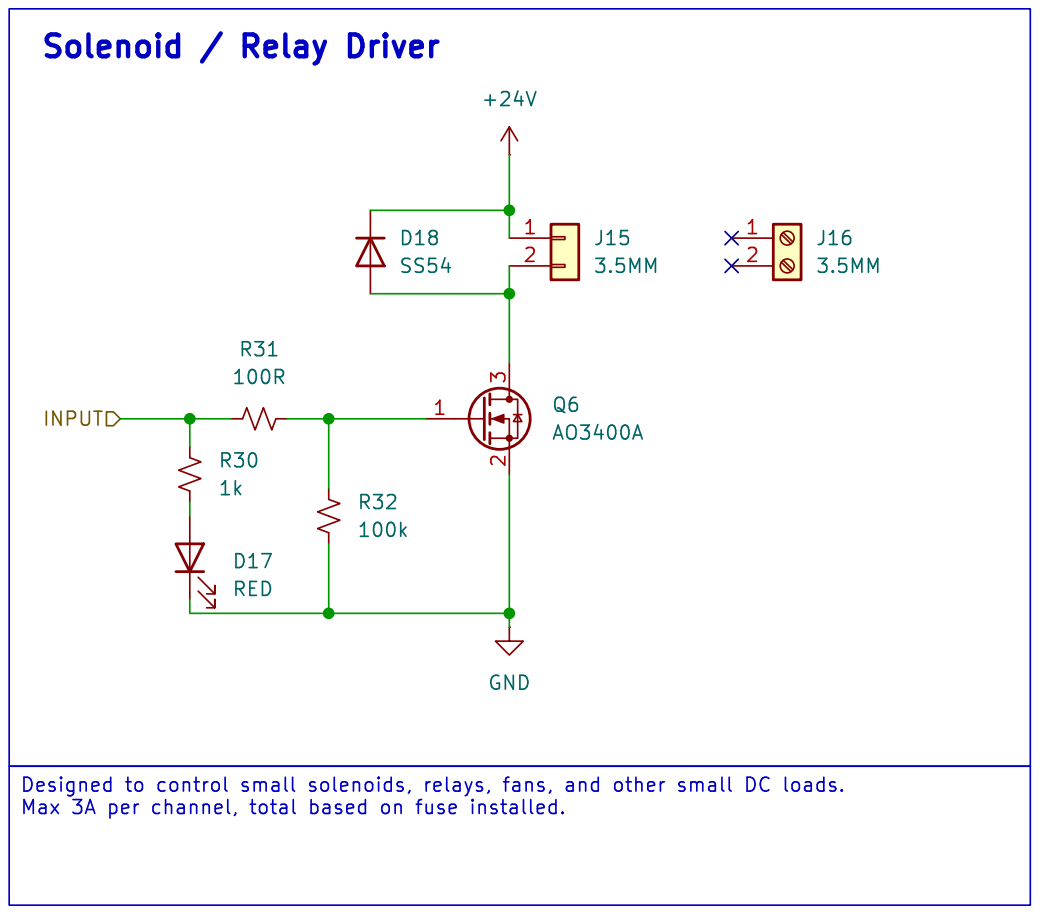
[picture p33: page 12]

Id: 14/18 Title: https://github.com/hoeken/brineomatic

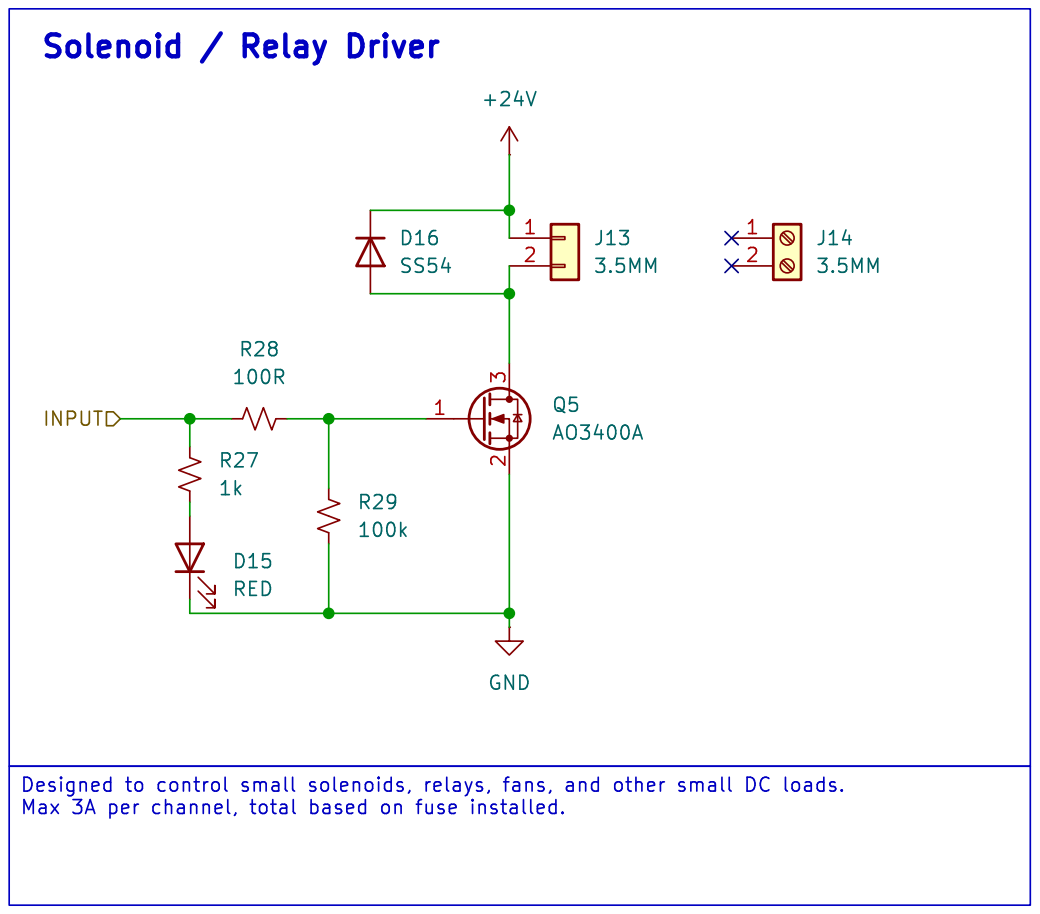
[picture p34: page 13]

Id: 13/18 Title: https://github.com/hoeken/brineomatic

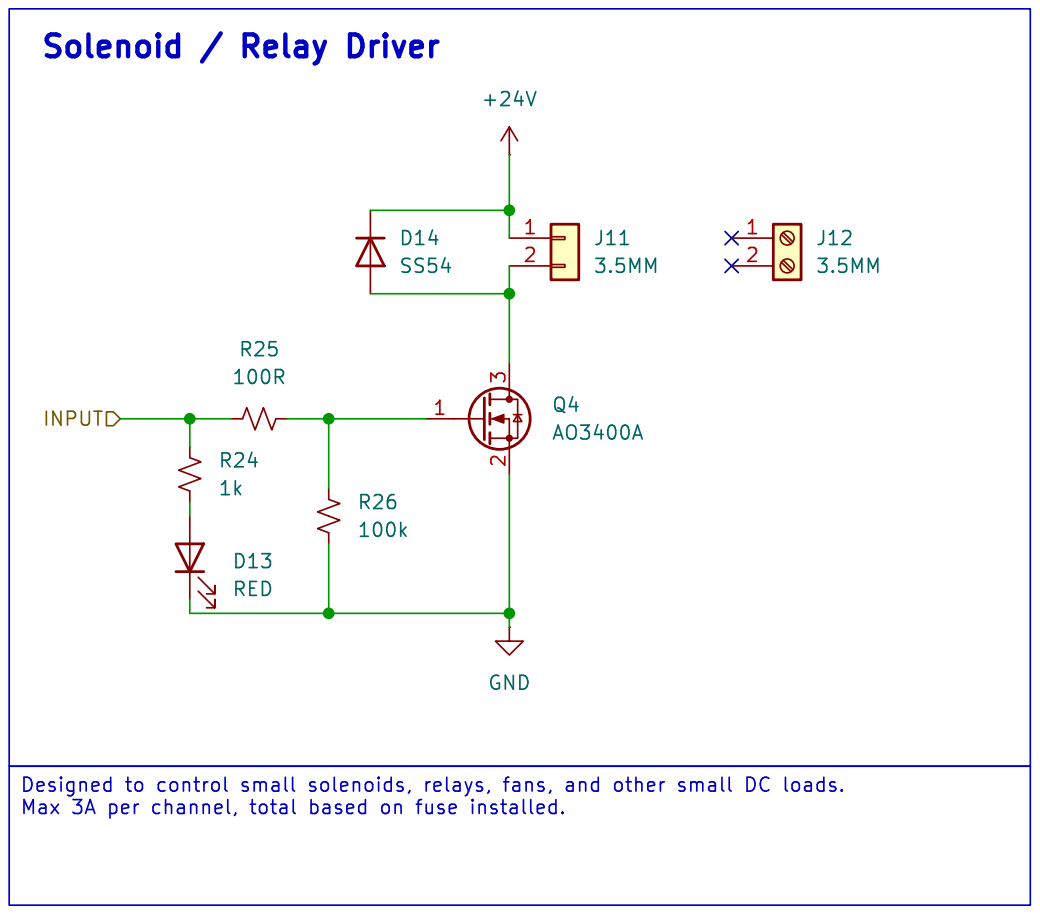
[picture p35: page 14]

Id: 12/18 Title: https://github.com/hoeken/brineomatic

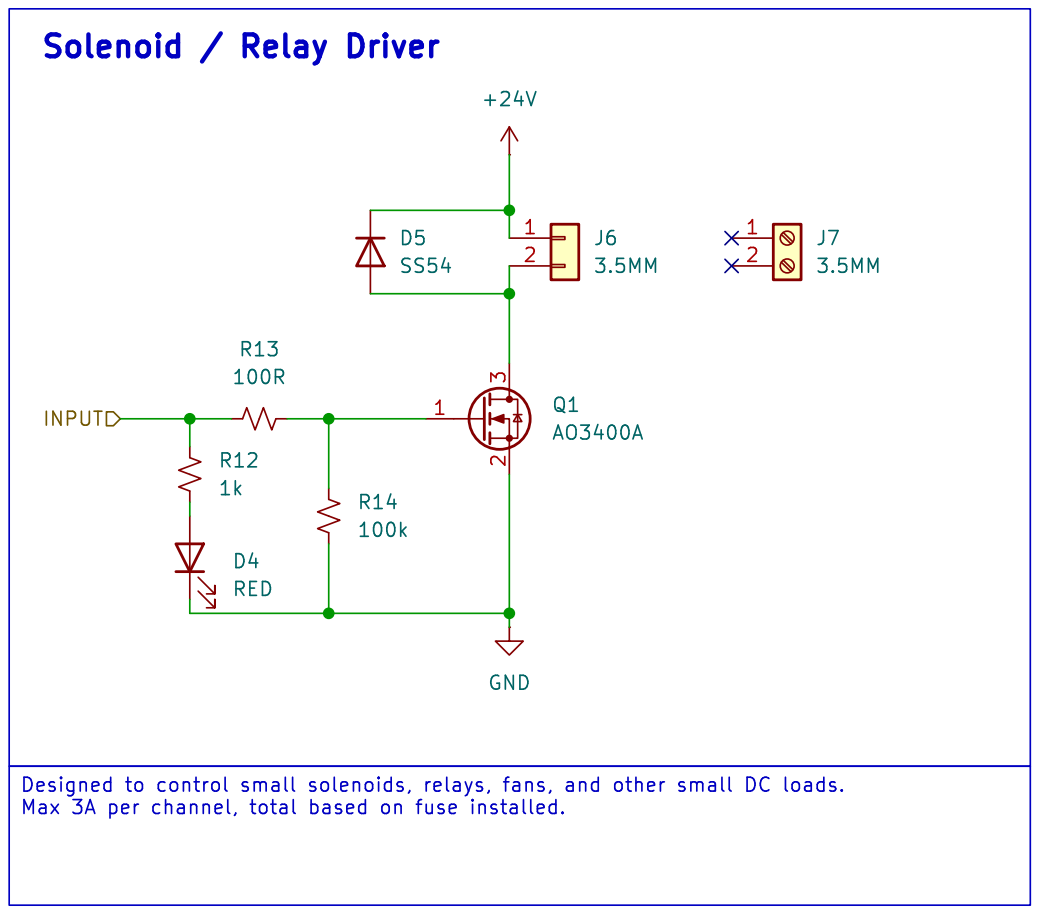
[picture p36: page 15]

Id: 7/18 Title: https://github.com/hoeken/brineomatic

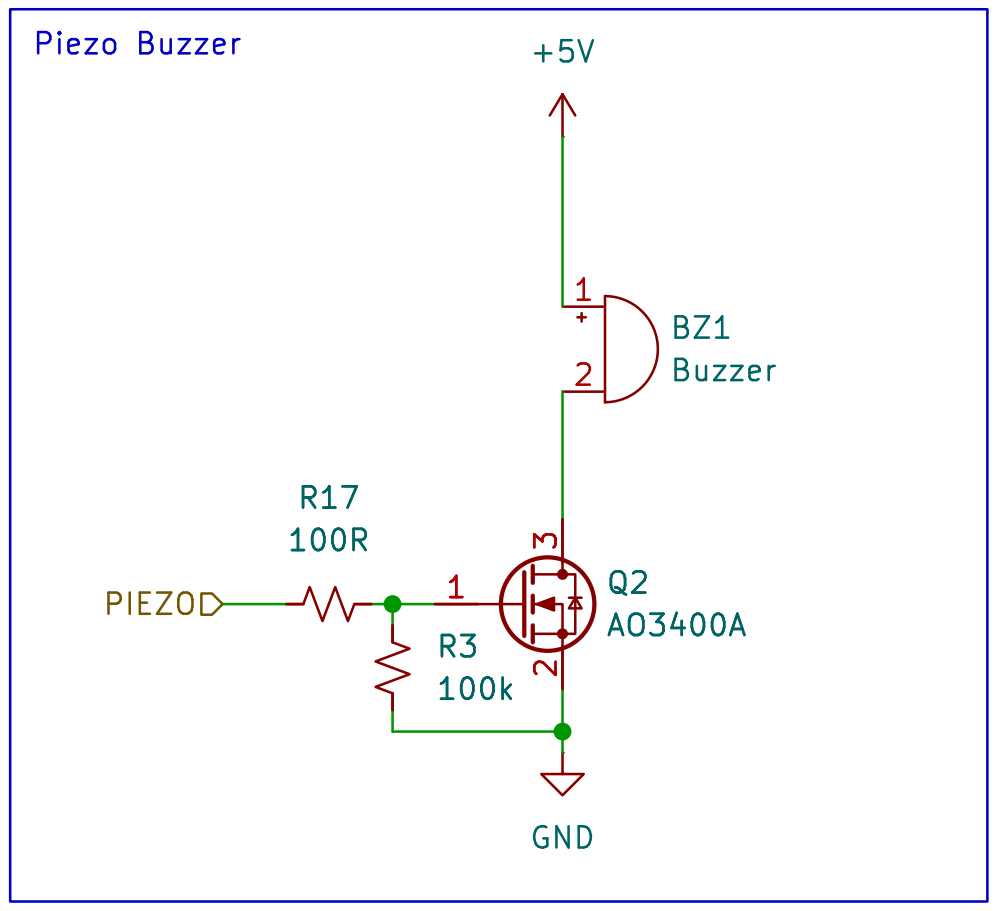
[picture p37: page 16]

File: piezo.kicad_sch Sheet: /Piezo/
Id: 9/18 Title: https://github.com/hoeken/brineomatic

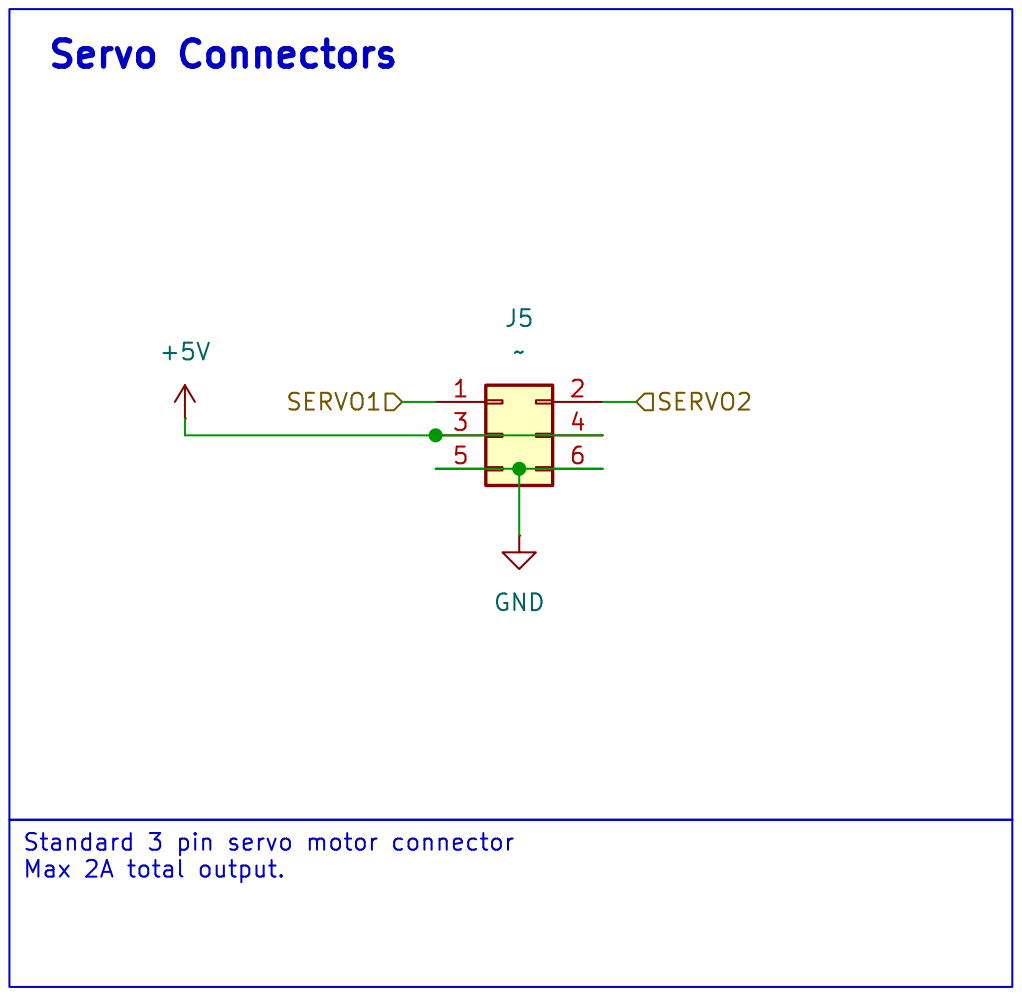
[picture p38: page 17]

File: servo.kicad_sch Sheet: /Servos/ GND

Id: 6/18 Title: https://github.com/hoeken/brineomatic

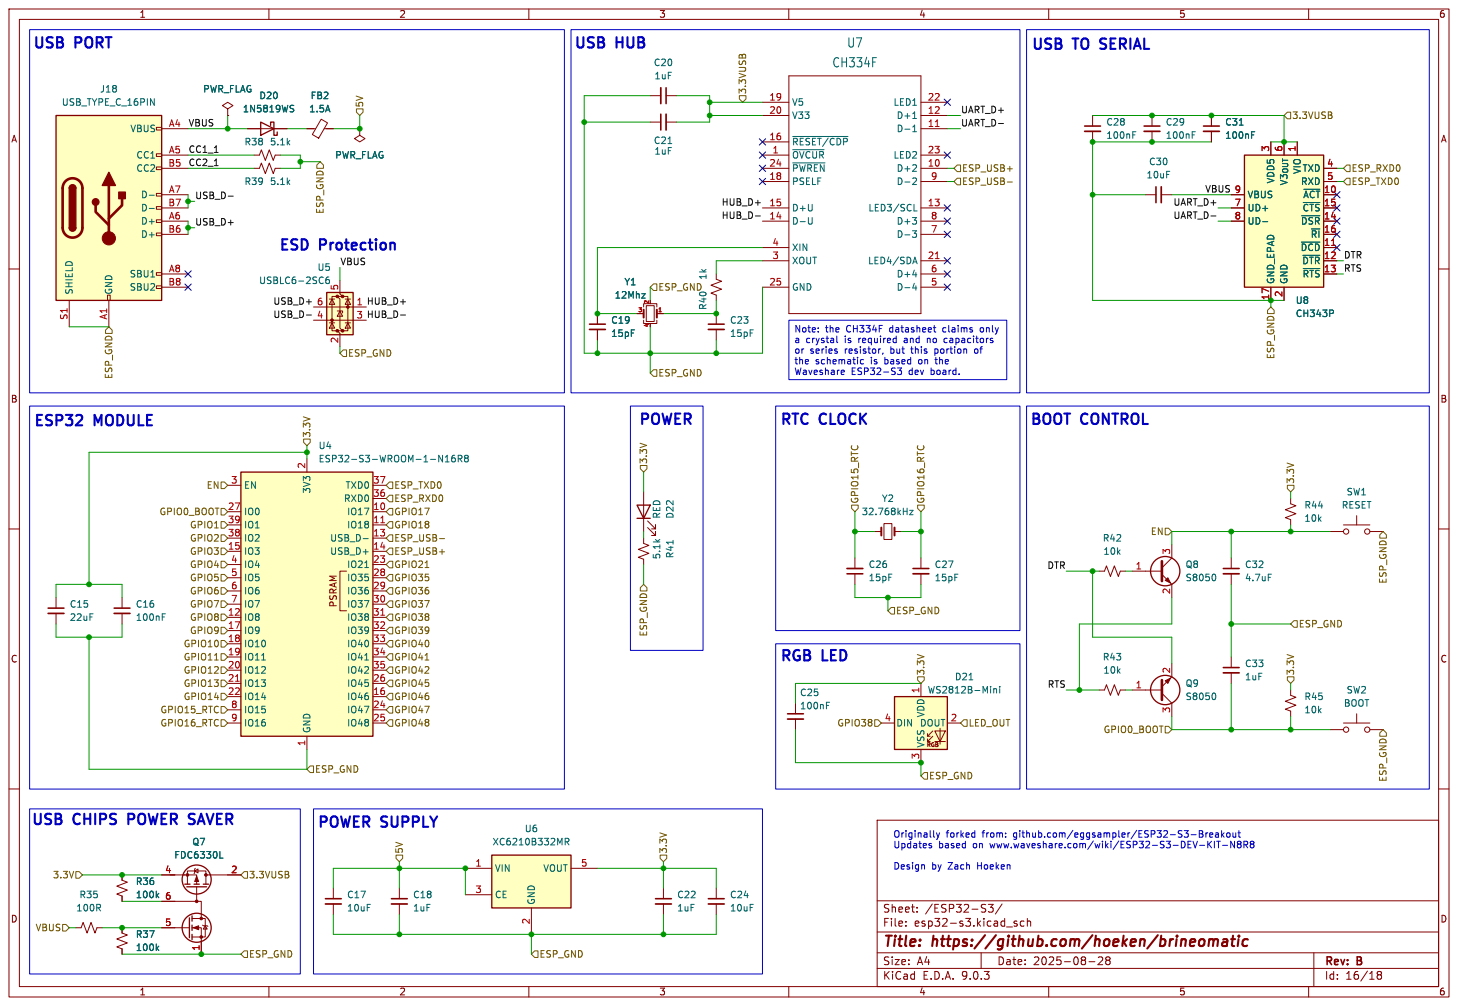
[picture p39: page 18]

1 TXD 4 RXD 5 ~{ACT} 10 ~{CTS} 15 ~{DSR} 14 ~{RI} 16 ~{DCD} 11 ~{DTR} 12 ~{RTS} 13 C31

1 TXD 4 RXD 5 ~{ACT} 10 ~{CTS} 15 ~{DSR} 14 ~{RI} 16 ~{DCD} 11 ~{DTR} 12 ~{RTS} 13 U8 CH343P

USB CHIPS POWER SAVER

Updates based on www.waveshare.com/wiki/ESP32-S3-DEV-KIT-N8R8 Design by Zach Hoeken

File: esp32-s3.kicad_sch Sheet: /ESP32-S3/
Id: 16/18 Title: https://github.com/hoeken/brineomatic
