hoeken/brineomatic/brineomatic/brineomatic.kicad_pcb

## KiCad design brineomatic/brineomatic.kicad_pcb (2026-06-15)

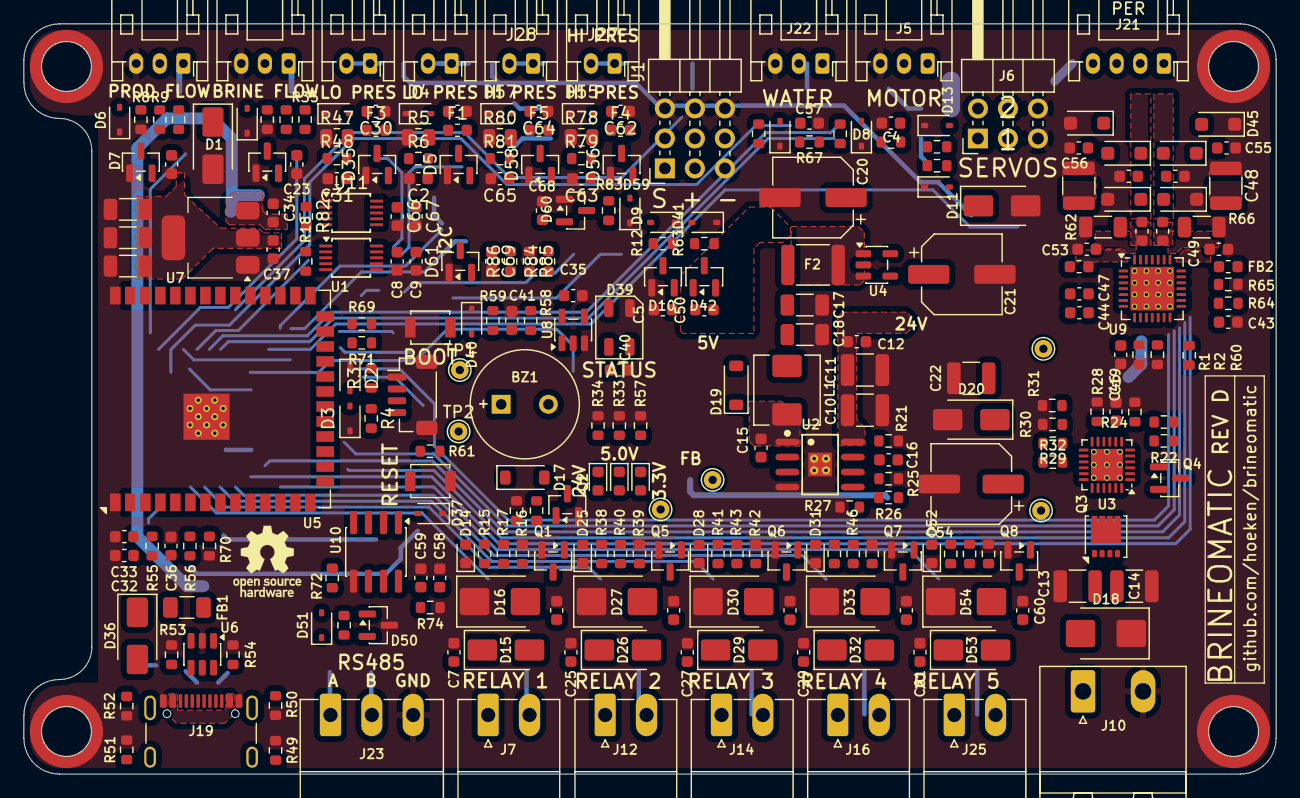
[picture p40: board brineomatic.kicad_pcb from above]

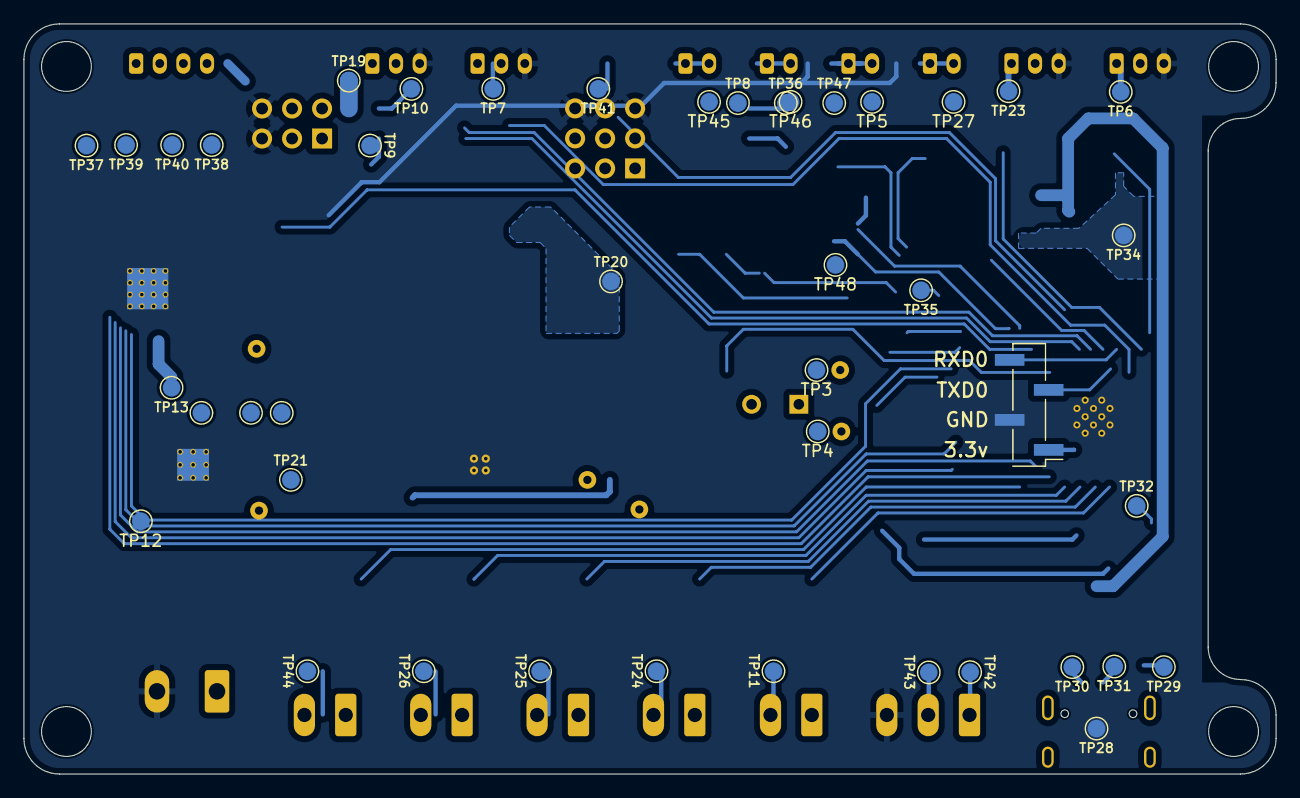
[picture p41: board brineomatic.kicad_pcb from below]

Board: 4 copper layers, 106.0 x 63.5 mm, 323 parts (43 on the bottom side), 132 nets.

Parts:
BZ1: Buzzer; MagneticBuzzer_QMB-09B-03
C1, C4, C6, C7, C24, C25, C26, C27, C28, C29, C30, C34, C36, C41, C57, C60, C61, C62, C64: 1uF; C_0603_1608Metric
C2, C5, C8, C12, C15, C19, C31, C33, C35, C40, C43, C44, C49, C50, C53, C59, C63, C65, C66, C68, C69: 100nF; C_0603_1608Metric
C3, C16, C23: 2.7nF; C_0603_1608Metric
C9, C58, C67: 10uF; C_0603_1608Metric
C10, C11, C13, C14, C22, C45, C48: 10uF; C_1210_3225Metric
C17, C18: 22uF; C_1206_3216Metric
C20, C21: 220uF / 16v; CP_Elec_6.3x5.4
C32: 22uF; C_0603_1608Metric
C37, C46: 4.7uF; C_0603_1608Metric
C38, C39, C42: 100uF / 6.3v; C_1206_3216Metric
C47: 22nF / 50v; C_0603_1608Metric
C51, C52, C55, C56: 470pf / 100v; C_0603_1608Metric
C54: 100uF / 35v; CP_Elec_6.3x7.7
D1, D11: SMAJ5.0A; D_SMA
D2, D3, D4, D6, D8, D9, D12, D13, D23, D34, D37, D40, D41, D49, D55, D57, D59: PESD3V3L1BA; D_SOD-323
D5, D10, D35, D42, D56, D58, D60, D61: BAV199; SOT-23
D7, D24: BAT54S; SOT-23
D14, D21, D22, D25, D28, D31, D38, D52: GREEN; LED_0603_1608Metric
D15, D20, D26, D29, D32, D53: SS54; D_SMA
D16, D18, D27, D30, D33, D54: SMBJ30CA; D_SMB
D17: B5819W; D_SOD-123
D19: 1N4148W; D_SOD-123
D36: SS34; D_SMA
D39: WS2812B-Mini; LED_WS2812B-Mini_PLCC4_3.5x3.5mm
D43, D44, D45, D46, D47, D48: SMF30CA; D_SOD-123F
D50: PSM712; SOT-23
D51: PSD12C; D_SOD-323
F1, F3, F4, F5: 30mA / 30v; Fuse_0603_1608Metric
F2: mSMD260; Fuse_1812_4532Metric
FB1: 1.5A; Fuse_1206_3216Metric
FB2, FB3, FB4, FB5: 50ohm @ 100mhz; L_0603_1608Metric
H1, H2, H3, H4: Standoff; SMTSO30XXX
J1: Conn_03x03; PinHeader_3x03_P2.54mm_Horizontal
J2: Conn_01x04_MountingPin; JST_SH_BM04B-SRSS-TB_1x04-1MP_P1.00mm_Vertical
J3, J18, J27, J28: JST_PH_S2B-PH-K_1x02_P2.00mm_Horizontal
J4, J5, J11, J22: JST_PH_S3B-PH-K_1x03_P2.00mm_Horizontal
J6: PinHeader_2x03_P2.54mm_Horizontal
J7, J12, J14, J16, J25: 3.5MM; PhoenixContact_MC_1,5_2-G-3.5_1x02_P3.50mm_Horizontal
J10: 5.08MM; PhoenixContact_MSTBA_2,5_2-G-5,08_1x02_P5.08mm_Horizontal
J19: USB_TYPE_C_16PIN; USB_C_Receptacle_GCT_USB4105-xx-A_16P_TopMnt_Horizontal
J20: Conn_01x04; PinHeader_1x04_P2.54mm_Vertical_SMD_Pin1Left
J21: Conn_01x04; JST_PH_S4B-PH-K_1x04_P2.00mm_Horizontal
J23: 3.5mm; PhoenixContact_MC_1,5_3-G-3.5_1x03_P3.50mm_Horizontal
L1: 6.8uH; L_Chilisin_BMRA00050530
Q1, Q2, Q5, Q6, Q7, Q8: Si2318; SOT-23
Q3: CSD19537Q3; VSON-8_3.3x3.3mm_P0.65mm_NexFET
Q4: BSS138; SOT-23
R1, R2, R6, R12, R16, R18, R20, R33, R39, R42, R45, R48, R56, R59, R63, R65, R69, R70, R71, R76, R79, R81, R82, R83, R86: 10k; R_0603_1608Metric
R3, R4, R8, R36: 2.2k; R_0603_1608Metric
R5, R47, R78, R80: 100R 0.1%; R_0805_2012Metric
R7, R35: 1.2K; R_0603_1608Metric
R9, R10, R37, R67: 4.7K; R_0603_1608Metric
R11, R13, R14, R55, R58, R68: 100R; R_0603_1608Metric
R15, R38, R41, R44, R60, R75: 1k; R_0603_1608Metric
R17, R19, R40, R43, R46, R77: 220R; R_0603_1608Metric
R21: 82k 1%; R_0603_1608Metric
R22: 820k 1%; R_0603_1608Metric
R23: 90.9k 1%; R_0603_1608Metric
R24, R31: 34k 1%; R_0603_1608Metric
R25, R32: 24k; R_0603_1608Metric
R26: 62k 1%; R_0603_1608Metric
R27: 11.8k 1%; R_0603_1608Metric
R28: 4.53k 1%; R_0603_1608Metric
R29: 383k 1%; R_0603_1608Metric
R30: 56k 1%; R_0603_1608Metric
R34: 100k; R_0603_1608Metric
R49, R50, R51, R52: 0R; R_0603_1608Metric
R53, R54, R57: 5.1k; R_0603_1608Metric
R61, R64, R72, R74: 20k; R_0603_1608Metric
R62, R66: 0.11R 1%; R_1206_3216Metric
R73: 120R; R_0603_1608Metric
R84: 300K 0.1%; R_0603_1608Metric
R85: 22K 0.1%; R_0603_1608Metric
SW1, SW2: SW_SPST_B3U-1000P
SYM1: Logo_Open_Hardware_Small; OSHW-Logo_5.7x6mm_SilkScreen
TP1, TP2, TP14, TP18, TP22, TP33: TestPoint_THTPad_D1.5mm_Drill0.7mm
TP3, TP4, TP5, TP6, TP7, TP8, TP9, TP10, TP11, TP12, TP13, TP15, TP16, TP17, TP19, TP20, TP21, TP23, TP24, TP25, TP26, TP27, TP28, TP29, TP30, TP31, TP32, TP34, TP35, TP36, TP37, TP38, TP39, TP40, TP41, TP42, TP43, TP44, TP45, TP46, TP47, TP48: TestPoint; TestPoint_Pad_D1.5mm
U1, U11: ADS1115IDGSR; TSSOP-10_3x3mm_P0.5mm
U2: RT7272BGSP; SOIC-8_L5.0-W4.0-P1.27-LS6.0-BL-EP2.0
U3: TPS26630RGE; QFN-24-1EP_4x4mm_P0.5mm_EP2.7x2.7mm_ThermalVias
U4: MAX40200AUK; SOT-23-5
U5: ESP32-S3-WROOM-1-N16R8; ESP32-S3-WROOM-1
U6: USBLC6-2SC6; SOT-23-6
U7: LDL1117S33R; SOT-223-3_TabPin2
U8: SN74LV1T34DBV; SOT-23-5
U9: TMC2209-LA; VQFN-28-1EP_5x5mm_P0.5mm_EP3.7x3.7mm_ThermalVias
U10: MAX3485; SOIC-8_3.9x4.9mm_P1.27mm

Connections:
5V_HIGH_POWER: C20.1, D11.1 (A1), F2.1, J6.3, J6.4, TP19.1, U4.1 (VDD), U4.3 (EN)
+3.3V: BZ1.1 (+), C4.1, C8.1, C9.1, C32.1, C33.1, C37.1, C38.1, C39.1, C42.1, C43.1, C57.1, C58.1, C59.1, C66.1, C67.1, D5.2 (K), D7.2 (K), D10.2 (K), D17.1 (K), D24.2 (K), D35.2 (K), D38.2 (A), D42.2 (K), D56.2 (K), D58.2 (K), D60.2 (K), D61.2 (K), J2.2, J5.1, J20.1, J22.1, R3.2, R4.2, R10.2, R18.2, R56.1, R59.2, R61.1, R67.2, R69.2, R71.2, R72.2, R82.2, TP33.1, TP34.1, U1.1 (ADDR), U1.8 (VDD), U5.2 (3V3), U7.2 (VO), U9.15 (VCC_IO), U10.8 (VCC), U11.8 (VDD)
+5V: C21.1, C34.1, C35.1, C40.1, D1.1 (A1), D21.2 (A), D39.1 (VDD), FB1.2, J1.2, J1.5, J1.8, J4.1, J11.1, R7.2, R35.2, TP20.1, TP22.1, U4.5 (OUT), U7.3 (VI), U8.5 (VCC)
+24V: C7.2, C10.1, C11.1, C12.1, C22.2, C25.2, C27.2, C29.2, C44.2, C45.1, C48.1, C49.2, C53.2, C54.1, C61.2, D15.1 (K), D20.1 (K), D22.2 (A), D26.1 (K), D29.1 (K), D32.1 (K), D53.1 (K), F1.2, F3.2, F4.2, F5.2, J7.1, J12.1, J14.1, J16.1, J25.1, R29.1, R32.1, R84.2, TP18.1, TP21.1, U2.8 (VIN), U3.17 (OUT), U3.18 (OUT), U9.22 (VS), U9.28 (VS)
/ADC1/ADC0: C68.1, D60.3 (COM), R83.2, U1.4 (AIN0)
/ADC1/ADC1: C5.1, D10.3 (COM), R12.2, U1.5 (AIN1)
/ADC1/ADC2: C50.1, D42.3 (COM), R63.2, U1.6 (AIN2)
/ADC1/ADC3: C69.1, D61.3 (COM), R86.2, TP48.1, U1.7 (AIN3)
/ADC2/ADC0: C31.1, D35.3 (COM), R48.2, U11.4 (AIN0)
/ADC2/ADC1: C2.1, D5.3 (COM), R6.2, U11.5 (AIN1)
/ADC2/ADC2: C65.1, D58.3 (COM), R81.2, U11.6 (AIN2)
/ADC2/ADC3: C63.1, D56.3 (COM), R79.2, U11.7 (AIN3)
/ESP32-S3/CC1_1: J19.A5 (CC1), R53.1
/ESP32-S3/CC2_1: J19.B5 (CC2), R54.1
/ESP32-S3/EN: R55.2, TP32.1, U5.3 (EN)
/ESP32-S3/ESP_RXD0: J20.4, U5.36 (RXD0)
/ESP32-S3/ESP_TXD0: J20.3, U5.37 (TXD0)
/ESP32-S3/ESP_USB+: U5.14 (USB_D+), U6.1 (I/O1)
/ESP32-S3/ESP_USB-: U5.13 (USB_D-), U6.3 (I/O2)
/ESP32-S3/GPIO0_BOOT: R58.2, TP35.1, U5.27 (IO0)
/ESP32-S3/GPIO38: U5.31 (IO38), U8.2 (A)
/ESP32-S3/USB_D+: J19.A6 (D+), J19.B6 (D+), TP30.1, U6.6 (I/O1)
/ESP32-S3/USB_D-: J19.A7 (D-), J19.B7 (D-), TP31.1, U6.4 (I/O2)
/ESP32-S3/VBUS: D36.2 (A), J19.A4 (VBUS), J19.A9 (VBUS), J19.B4 (VBUS), J19.B9 (VBUS), TP29.1, U6.5 (VBUS)
/Power Supply/PRE_24: C13.2, C14.2, D18.2 (A2), J10.1, Q3.1 (S), Q3.2 (S), Q3.3 (S), Q4.2 (S), R22.1, TP12.1, TP13.1, U3.5 (IN_SYS)
/Power Supply/SW: C15.2, L1.1, U2.1 (SW)
/Stepper Driver/MS1: R1.1, U9.9 (MS1/AD0)
/Stepper Driver/MS2: R2.1, U9.10 (MS2/AD1)
/Stepper Driver/OA1: FB3.1, U9.24 (OA1)
/Stepper Driver/OA2: FB2.1, U9.21 (OA2)
/Stepper Driver/OB1: FB4.1, U9.26 (OB1)
/Stepper Driver/OB2: FB5.1, U9.1 (OB2)
ADC1_ALERT: R18.1, U1.2 (ALERT/RDY), U5.35 (IO42)
ADC2_ALERT: R82.1, U5.15 (IO3), U11.2 (ALERT/RDY)
BRINE_FLOWMETER: C23.1, D24.3 (COM), R37.2, U5.38 (IO2)
BRINE_TDS: D41.2 (A2), J1.7, R63.1, TP36.1
BUZZER: R19.2, U5.22 (IO14)
GND: C1.1, C2.2, C3.2, C4.2, C5.2, C6.1, C7.1, C8.2, C9.2, C10.2, C11.2, C12.2, C13.1, C14.1, C17.2, C18.2, C19.2, C20.2, C21.2, C22.1, C23.2, C24.1, C25.1, C26.1, C27.1, C28.1, C29.1, C30.1, C31.2, C32.2, C33.2, C34.2, C35.2, C36.2, C37.2, C38.2, C39.2, C40.2, C41.1, C42.2, C43.2, C45.2, C46.2, C48.2, C49.1, C50.2, C51.1, C52.2, C53.1, C54.2, C55.1, C56.2, C57.2, C58.2, C59.2, C60.1, C61.1, C62.1, C63.2, C64.1, C65.2, C66.2, C67.2, C68.2, C69.2, D1.2 (A2), D2.1 (A1), D3.1 (A1), D4.1 (A1), D5.1 (A), D6.1 (A1), D7.1 (A), D8.1 (A1), D9.1 (A1), D10.1 (A), D11.2 (A2), D12.1 (A1), D13.1 (A1), D14.1 (K), D16.1 (A1), D18.1 (A1), D20.2 (A), D23.1 (A1), D24.1 (A), D25.1 (K), D27.1 (A1), D28.1 (K), D30.1 (A1), D31.1 (K), D33.1 (A1), D34.1 (A1), D35.1 (A), D37.1 (A1), D39.3 (VSS), D40.1 (A1), D41.1 (A1), D42.1 (A), D43.1 (A1), D44.2 (A2), D45.1 (A1), D48.2 (A2), D49.1 (A1), D50.3 (common), D52.1 (K), D54.1 (A1), D55.1 (A1), D56.1 (A), D57.1 (A1), D58.1 (A), D59.1 (A1), D60.1 (A), D61.1 (A), H1.1, H2.1, H3.1, H4.1, J1.3, J1.6, J1.9, J2.1, J2.MP (MountPin), J4.3, J5.3, J6.5, J6.6, J10.2, J11.3, J19.A1 (GND), J19.A12 (GND), J19.B1 (GND), J19.B12 (GND), J20.2, J22.3, J23.3, Q1.2 (S), Q2.2 (S), Q5.2 (S), Q6.2 (S), Q7.2 (S), Q8.2 (S), R1.2, R2.2, R5.1, R8.1, R16.1, R20.2, R21.2, R24.2, R25.2, R27.2, R28.2, R30.2, R31.2, R33.2, R34.2, R36.1, R39.1, R42.1, R45.1, R47.1, R49.1, R50.1, R51.1, R52.1, R53.2, R54.2, R57.2, R62.1, R65.1, R66.2, R70.1, R74.1, R76.1, R78.1, R80.1, R85.1, SW1.2, SW2.2, TP28.1, U1.3 (GND), U2.4 (GND), U3.8 (GND), U3.11 (MODE), U3.25 (GND), U4.2 (GND), U5.1 (GND), U5.40 (GND), U5.41 (GND), U6.2 (GND), U7.1 (GND), U8.3 (GND), U9.3 (GND), U9.13 (CLK), U9.18 (GND), U9.20 (STDBY), U9.25 (NC), U9.29 (GND), U10.5 (GND), U11.1 (ADDR), U11.3 (GND)
MOTOR_TEMPERATURE: R11.1, U5.4 (IO4)
unnamed: BZ1.2 (-), D17.2 (A), Q2.3 (D)
unnamed: C16.1, R25.1
unnamed: D4.2 (A2), J3.2, R5.2, R6.1, TP5.1
unnamed: D6.2 (A2), J4.2, R7.1, R8.2, R9.1, TP6.1
unnamed: D8.2 (A2), J5.2, R10.1, R11.2, TP7.1
unnamed: D12.2 (A2), J6.1, R13.1, TP9.1
unnamed: D13.2 (A2), J6.2, R14.2, TP10.1
unnamed: D14.2 (A), R15.1
unnamed: C6.2, D15.2 (A), D16.2 (A2), J7.2, Q1.3 (D), TP11.1
unnamed: C17.1, C18.1, D19.2 (A), F2.2, L1.2, R26.1, TP14.1
unnamed: C15.1, D19.1 (K), U2.2 (BOOT)
unnamed: D21.1 (K), R33.1
unnamed: D22.1 (K), R34.1
unnamed: D23.2 (A2), J11.2, R35.1, R36.2, R37.1, TP23.1
unnamed: D25.2 (A), R38.1
unnamed: C24.2, D26.2 (A), D27.2 (A2), J12.2, Q5.3 (D), TP24.1
unnamed: D28.2 (A), R41.1
unnamed: C26.2, D29.2 (A), D30.2 (A2), J14.2, Q6.3 (D), TP25.1
unnamed: D31.2 (A), R44.1
unnamed: C28.2, D32.2 (A), D33.2 (A2), J16.2, Q7.3 (D), TP26.1
unnamed: D34.2 (A2), J18.2, R47.2, R48.1, TP27.1
unnamed: D36.1 (K), FB1.1
unnamed: C36.1, D37.2 (A2), R55.1, R56.2, SW1.1
unnamed: D38.1 (K), R57.1
unnamed: D39.4 (DIN), U8.4 (Y)
unnamed: C41.2, D40.2 (A2), R58.1, R59.1, SW2.1
unnamed: C51.2, D43.2 (A2), D46.2 (A2), FB3.2, J21.2, TP39.1
unnamed: C52.1, D44.1 (A1), D47.1 (A1), FB4.2, J21.3, TP40.1
unnamed: C55.2, D45.2 (A2), D46.1 (A1), FB2.2, J21.1, TP37.1
unnamed: C56.1, D47.2 (A2), D48.1 (A1), FB5.2, J21.4, TP38.1
unnamed: D49.2 (A2), J22.2, R67.1, R68.2, TP41.1
unnamed: D50.1 (A1), D51.2 (A2), J23.1, R72.1, R73.2, TP42.1, U10.6 (A)
unnamed: D50.2 (A2), D51.1 (A1), J23.2, R73.1, R74.2, TP43.1, U10.7 (B)
unnamed: D52.2 (A), R75.1
unnamed: C60.2, D53.2 (A), D54.2 (A2), J25.2, Q8.3 (D), TP44.1
unnamed: D55.2 (A2), J27.2, R78.2, R79.1, TP45.1
unnamed: D57.2 (A2), J28.2, R80.2, R81.1, TP46.1
unnamed: C1.2, F1.1, J3.1
unnamed: C30.2, F3.1, J18.1
unnamed: J19.S1 (SHIELD), R49.2, R50.2, R51.2, R52.2
unnamed: C62.2, F4.1, J27.1
unnamed: C64.2, F5.1, J28.1
unnamed: Q1.1 (G), R17.2
unnamed: Q2.1 (G), R19.1, R20.1
unnamed: Q3.5 (D), U3.1 (IN), U3.2 (IN)
unnamed: Q3.4 (G), Q4.3 (D), U3.3 (B_GATE)
unnamed: Q4.1 (G), U3.4 (DRV)
unnamed: Q5.1 (G), R40.2
unnamed: Q6.1 (G), R43.2
unnamed: Q7.1 (G), R46.2
unnamed: Q8.1 (G), R77.2
unnamed: R84.1, R85.2, R86.1
unnamed: C16.2, U2.6 (COMP)
unnamed: R26.2, R27.1, U2.5 (FB)
unnamed: R21.1, U2.7 (RLIM)
unnamed: R28.1, U3.10 (ILIM)
unnamed: R31.1, U3.13 (IMON)
unnamed: R23.2, R24.1, U3.7 (OVP)
unnamed: R29.2, R30.1, U3.15 (PGTH)
unnamed: R22.2, R23.1, U3.6 (UVLO)
unnamed: C19.1, U3.9 (dVdT)
unnamed: TP15.1, U3.14 (~FLT)
unnamed: TP16.1, U3.12 (~SHDN)
unnamed: C46.1, R64.2, U9.8 (5VOUT)
unnamed: R66.1, U9.23 (BRA)
unnamed: R62.2, U9.27 (BRB)
unnamed: C47.1, U9.5 (CPI)
unnamed: C47.2, U9.4 (CPO)
unnamed: C44.1, U9.6 (VCP)
unnamed: R64.1, R65.2, U9.17 (VREF)
PGOOD: R32.2, TP17.1, U2.3 (EN), U3.16 (PGOOD)
PRODUCT_FLOWMETER: C3.1, D7.3 (COM), R9.2, U5.39 (IO1)
PRODUCT_TDS: D9.2 (A2), J1.4, R12.1, TP8.1
RS485_DERE: R70.2, U5.5 (IO5), U10.2 (~RE), U10.3 (DE)
RS485_DI: R69.1, U5.25 (IO48), U10.4 (DI)
RS485_RO: R71.1, U5.24 (IO47), U10.1 (RO)
SCL: D3.2 (A2), J2.4, R4.1, TP2.1, TP4.1, U1.10 (SCL), U5.20 (IO12), U11.10 (SCL)
SDA: D2.2 (A2), J2.3, R3.1, TP1.1, TP3.1, U1.9 (SDA), U5.21 (IO13), U11.9 (SDA)
SERVO1: R13.2, U5.33 (IO40)
SERVO2: R14.1, U5.34 (IO41)
SOLENOID1: R15.2, R16.2, R17.1, U5.6 (IO6)
SOLENOID2: R38.2, R39.2, R40.1, U5.7 (IO7)
SOLENOID3: R41.2, R42.2, R43.1, U5.8 (IO15)
SOLENOID4: R44.2, R45.2, R46.1, U5.9 (IO16)
SOLENOID5: R75.2, R76.2, R77.1, U5.12 (IO8)
SOURCE_TDS: D59.2 (A2), J1.1, R83.1, TP47.1
TMC2209_DIAG: U5.23 (IO21), U9.11 (DIAG)
TMC2209_DIR: U5.11 (IO18), U9.19 (DIR)
TMC2209_EN: R61.2, U5.19 (IO11), U9.2 (~EN)
TMC2209_RX: R60.1, U5.17 (IO9)
TMC2209_STEP: U5.10 (IO17), U9.16 (STEP)
TMC2209_TX: R60.2, U5.18 (IO10), U9.14 (~PD/UART)
WATER_TEMPERATURE: R68.1, U5.32 (IO39)
