hoeken/brineomatic/(commit log)

2024-10-04 rough first pass at the schematic.
    [1115_adc.kicad_sch, DS18B20.kicad_sch, brineomatic.kicad_pcb, brineomatic.kicad_sch, calculations.ods, dc_motor_driver.kicad_sch, h_bridge_driver.kicad_sch, lift_pump_driver.kicad_sch]
2024-10-04 getting closer. added tds
    [1115_adc.kicad_sch, brineomatic.kicad_sch, pressure_sensor.kicad_sch, servo.kicad_sch, solenoid_driver.kicad_sch, tds.kicad_sch]
2024-10-04 starting to shape up, footprints etc
    [1115_adc.kicad_sch, DS18B20.kicad_sch, brineomatic.kicad_pcb, brineomatic.kicad_sch, dc_motor_driver.kicad_sch, lift_pump_driver.kicad_sch, ntc.kicad_sch, power_supply.kicad_sch]
2024-10-06 starting to look good.
    [DS18B20.kicad_sch, brineomatic.kicad_pcb, brineomatic.kicad_sch, dc_motor_driver.kicad_sch, esp32 pin selection.ods, lift_pump_driver.kicad_sch, ntc.kicad_sch, power_supply.kicad_sch]
2024-10-06 silkscreen and more layout tweaks.
    [brineomatic.kicad_pcb, brineomatic.kicad_sch]
2024-10-06 updated bom and prepping for Rev A
    [1115_adc.kicad_sch, DS18B20.kicad_sch, brineomatic.kicad_pcb, brineomatic.kicad_sch, dc_motor_driver.kicad_sch, ntc.kicad_sch, power_supply.kicad_sch, pressure_sensor.kicad_sch]
2024-10-06 updates parts, footprints, etc. ready for production.
    [1115_adc.kicad_sch, brineomatic.kicad_pcb, dc_motor_driver.kicad_sch, power_supply.kicad_sch, pressure_sensor.kicad_sch, servo.kicad_sch, solenoid_driver.kicad_sch]
2024-10-06 updated plumbing and overview schematics.
2024-10-23 started in on RevA testing
    [brineomatic.kicad_sch, servo.kicad_sch]
2024-10-25 added alert line to adc
    [1115_adc.kicad_sch, brineomatic.kicad_sch, esp32 pin selection.ods]
2024-10-25 fixed bat54s placement.
    [ntc.kicad_sch, pressure_sensor.kicad_sch, pulse_counter.kicad_sch, tds.kicad_sch]
2024-10-26 added piezo buzzer
    [brineomatic.kicad_sch, esp32 pin selection.ods, piezo.kicad_sch]
2024-10-27 case design is finished.
2024-11-09 updated power wiring schematic
2024-11-27 added more assets and bom script.
2024-11-27 tidy up files.
    [calculations.ods, esp32 pin selection.ods]
2025-07-31 kicad v9 and updated todo.
    [1115_adc.kicad_sch, DS18B20.kicad_sch, brineomatic.kicad_pcb, brineomatic.kicad_sch, dc_motor_driver.kicad_sch, ntc.kicad_sch, piezo.kicad_sch, power_supply.kicad_sch]
2025-08-11 did a bunch of schematic work for Rev B
    [brineomatic.kicad_sch, esp32 pin selection.ods, pulse_counter.kicad_sch, tds.kicad_sch, tmc2209.kicad_sch]
2025-08-11 worked on schematic and layout a bit more.
    [1115_adc.kicad_sch, DS18B20.kicad_sch, brineomatic.kicad_pcb, brineomatic.kicad_sch, piezo.kicad_sch, power_supply.kicad_sch, pressure_sensor.kicad_sch, pulse_counter.kicad_sch]
2025-08-13 lots of progress on Rev B
    [DS18B20.kicad_sch, brineomatic.kicad_pcb, brineomatic.kicad_sch, esp32 pin selection.ods, piezo.kicad_sch, servo.kicad_sch, tmc2209.kicad_sch]
2025-08-13 first pass fully routed
    [brineomatic.kicad_pcb, brineomatic.kicad_sch, esp32 pin selection.ods, piezo.kicad_sch]
2025-08-13 added fuse on 3.3v
    [brineomatic.kicad_pcb, brineomatic.kicad_sch]
2025-08-14 reverse polarity circuit added
    [brineomatic.kicad_pcb, power_supply.kicad_sch]
2025-08-14 more work on the power circuitry
    [brineomatic.kicad_pcb, power_supply.kicad_sch]
2025-08-14 stepstick headers updated.
    [brineomatic.kicad_pcb, tmc2209.kicad_sch]
2025-08-14 updated wiring and connector to match dfrobot for tds sensors
    [brineomatic.kicad_pcb, tds.kicad_sch]
2025-08-14 moved to bom friendly stepper driver mount
    [brineomatic.kicad_pcb, tmc2209.kicad_sch]
2025-09-29 switched to onboard esp32-s3 and re-drew tmc2209 driver
    [1115_adc.kicad_sch, DS18B20.kicad_sch, brineomatic.kicad_pcb, brineomatic.kicad_sch, esp32 pin selection.ods, esp32-s3.kicad_sch, piezo.kicad_sch, power_supply.kicad_sch]
2025-09-29 tmc2209 driver schematic checked and laid out nicely.
    [1115_adc.kicad_sch, DS18B20.kicad_sch, brineomatic.kicad_pcb, brineomatic.kicad_sch, esp32-s3.kicad_sch, piezo.kicad_sch, power_supply.kicad_sch, pressure_sensor.kicad_sch]
2025-09-29 single 5v supply works just fine
    [brineomatic.kicad_pcb, brineomatic.kicad_sch, esp32-s3.kicad_sch, power_supply.kicad_sch]
2025-09-30 updated board edges and general tweaks
    [brineomatic.kicad_pcb, brineomatic.kicad_sch]
2025-09-30 all the important parts have 3d models now.
    [brineomatic.kicad_pcb, power_supply.kicad_sch, tmc2209.kicad_sch]
2025-10-01 aligned all connectors with board edge
    [brineomatic.kicad_pcb, esp32-s3.kicad_sch, power_supply.kicad_sch, tmc2209.kicad_sch]
2025-10-01 fully routed and erc/drc passed
    [brineomatic.kicad_pcb, brineomatic.kicad_sch, esp32-s3.kicad_sch, piezo.kicad_sch, power_supply.kicad_sch, solenoid_driver.kicad_sch, tmc2209.kicad_sch]
2025-10-01 removed the onboard fuse.
    [brineomatic.kicad_pcb, power_supply.kicad_sch]
2025-10-01 re-added fuse, switched to 5x20mm
    [brineomatic.kicad_pcb, power_supply.kicad_sch]
2025-10-02 silkscreen good and all drc errors fixed.
    [brineomatic.kicad_pcb, power_supply.kicad_sch, solenoid_driver.kicad_sch, tmc2209.kicad_sch]
2025-10-02 worked on bom for rev b prototype run
    [1115_adc.kicad_sch, DS18B20.kicad_sch, brineomatic.kicad_pcb, brineomatic.kicad_sch, esp32-s3.kicad_sch, piezo.kicad_sch, power_supply.kicad_sch, pressure_sensor.kicad_sch]
2025-10-02 updated jlc parts rotations and placement offsets
    [DS18B20.kicad_sch, brineomatic.kicad_pcb, brineomatic.kicad_sch, esp32-s3.kicad_sch, piezo.kicad_sch, power_supply.kicad_sch, pulse_counter.kicad_sch, servo.kicad_sch]
2025-10-02 a few last minute routing tweaks
    [brineomatic.kicad_pcb]
2025-10-02 copied back from esp32-s3-template
    [esp32-s3.kicad_sch]
2025-10-02 via stitching, a couple minor changes, i think its ready for production
    [brineomatic.kicad_pcb, esp32-s3.kicad_sch, piezo.kicad_sch, tmc2209.kicad_sch]
2025-10-02 piezo resistor
    [piezo.kicad_sch]
2025-10-04 added qwiic i2c connector
    [1115_adc.kicad_sch, DS18B20.kicad_sch, brineomatic.kicad_pcb, brineomatic.kicad_sch, esp32-s3.kicad_sch, piezo.kicad_sch, power_supply.kicad_sch, pressure_sensor.kicad_sch]
2025-10-05 added missing cap to reverse polarity protection circuit
    [brineomatic.kicad_pcb, power_supply.kicad_sch]
2025-10-08 added case and schematic
2025-10-22 added bom
    [Rainman Control Panel BOM - Rev A.csv]
2025-11-28 added connector/pinout documentation for rev b board.
2025-11-28 added node red flow example
2025-11-29 straightened board bottom edge
    [brineomatic.kicad_pcb]
2025-11-29 added pullup resistor to adc alert
    [1115_adc.kicad_sch, DS18B20.kicad_sch, brineomatic.kicad_pcb, brineomatic.kicad_sch, esp32-s3.kicad_sch, piezo.kicad_sch, power_supply.kicad_sch, pressure_sensor.kicad_sch]
2025-11-29 changed mosfet pulldowns to 10k. moved 5v to esp32_5v to power everything over usb.
    [brineomatic.kicad_pcb, power_supply.kicad_sch, solenoid_driver.kicad_sch]
2025-11-29 added rs485 circuit
    [brineomatic.kicad_pcb, brineomatic.kicad_sch, power_supply.kicad_sch]
2025-11-29 added water temperature connector
    [DS18B20.kicad_sch, brineomatic.kicad_sch, rs485.kicad_sch]
2025-11-29 5v power supply is sorted.
    [DS18B20.kicad_sch, brineomatic.kicad_sch, power_supply.kicad_sch, pulse_counter.kicad_sch, servo.kicad_sch]
2025-11-29 stacked tds, removed stepper vref, pulled in esp32-s3 schematic, added extra relay output
    [DS18B20.kicad_sch, brineomatic.kicad_pcb, brineomatic.kicad_sch, esp32-s3.kicad_sch, pressure_sensor.kicad_sch, pulse_counter.kicad_sch, rs485.kicad_sch, solenoid_driver.kicad_sch]
2025-11-29 added sendit piezo
    [DS18B20.kicad_sch, brineomatic.kicad_pcb, esp32-s3.kicad_sch, piezo.kicad_sch, power_supply.kicad_sch, pressure_sensor.kicad_sch, pulse_counter.kicad_sch, rs485.kicad_sch]
2025-11-29 worked on component layout a bit more.
    [brineomatic.kicad_pcb]
2025-11-29 all connectors are now flush withe 3mm outside edge of the case
    [brineomatic.kicad_pcb, brineomatic.kicad_sch, esp32-s3.kicad_sch, power_supply.kicad_sch, pressure_sensor.kicad_sch, pulse_counter.kicad_sch, rs485.kicad_sch, servo.kicad_sch]
2025-11-29 connector placement done
    [brineomatic.kicad_pcb]
2025-11-30 schematic tidy, usb c position verified, component placement work.
    [1115_adc.kicad_sch, DS18B20.kicad_sch, brineomatic.kicad_pcb, brineomatic.kicad_sch, esp32-s3.kicad_sch, piezo.kicad_sch, power_supply.kicad_sch, pressure_sensor.kicad_sch]
2025-11-30 added voltage divider to vref. more component shuffling.
    [1115_adc.kicad_sch, DS18B20.kicad_sch, brineomatic.kicad_pcb, brineomatic.kicad_sch, esp32-s3.kicad_sch, piezo.kicad_sch, power_supply.kicad_sch, pressure_sensor.kicad_sch]
2025-11-30 power routing is done.
    [brineomatic.kicad_pcb, piezo.kicad_sch, solenoid_driver.kicad_sch]
2025-12-01 board fully routed first pass.
    [1115_adc.kicad_sch, brineomatic.kicad_pcb, brineomatic.kicad_sch, esp32-s3.kicad_sch, power_supply.kicad_sch]
2025-12-01 more esd protection, drc passing, silkscreen fixed
    [1115_adc.kicad_sch, DS18B20.kicad_sch, brineomatic.kicad_pcb, brineomatic.kicad_sch, esp32-s3.kicad_sch, piezo.kicad_sch, power_supply.kicad_sch, pressure_sensor.kicad_sch]
2025-12-02 layout tweaks
    [brineomatic.kicad_pcb, brineomatic.kicad_sch]
2025-12-02 via stitching plugin is sick
    [brineomatic.kicad_pcb]
2025-12-02 bom and cpl file are good.
    [brineomatic.kicad_pcb, brineomatic.kicad_sch, power_supply.kicad_sch]
2025-12-02 removed rs485 jumper and added silkscreen
    [brineomatic.kicad_pcb, rs485.kicad_sch]
2025-12-02 small cleanups on schematic
    [DS18B20.kicad_sch, brineomatic.kicad_pcb, esp32-s3.kicad_sch, power_supply.kicad_sch]
2025-12-02 updated the 4-20ma sensor resistor value
    [brineomatic.kicad_pcb, pressure_sensor.kicad_sch, pulse_counter.kicad_sch, tds.kicad_sch]
2025-12-03 value and component updates
    [brineomatic.kicad_pcb, piezo.kicad_sch, solenoid_driver.kicad_sch]
2025-12-03 added back up usb serial converter headers
    [DS18B20.kicad_sch, brineomatic.kicad_pcb, brineomatic.kicad_sch, esp32-s3.kicad_sch, power_supply.kicad_sch, rs485.kicad_sch, solenoid_driver.kicad_sch, tds.kicad_sch]
2025-12-03 added missing gnd test point
    [brineomatic.kicad_pcb, esp32-s3.kicad_sch, power_supply.kicad_sch]
2025-12-07 added more esd protection to the power rails (24v, 5v, 3.3v)
    [1115_adc.kicad_sch, DS18B20.kicad_sch, brineomatic.kicad_pcb, brineomatic.kicad_sch, esp32-s3.kicad_sch, piezo.kicad_sch, power_supply.kicad_sch, pressure_sensor.kicad_sch]
2025-12-07 removed old schematics
    [dc_motor_driver.kicad_sch, h_bridge_driver.kicad_sch, lift_pump_driver.kicad_sch, motor_driver.kicad_sch, ntc.kicad_sch, piezo.kicad_sch, pressure-sensor.kicad_sch]
2025-12-08 re-arranged pins to avoid boot glitches on solenoids
    [brineomatic.kicad_pcb, brineomatic.kicad_sch]
2025-12-08 sprinkled in a few more gnd vias
    [brineomatic.kicad_pcb, brineomatic.kicad_sch]
2025-12-09 left attachment points a bit biger
    [brineomatic.kicad_pcb]
2025-12-09 switched to the LDL1117 ldo
    [DS18B20.kicad_sch, brineomatic.kicad_pcb, esp32-s3.kicad_sch, power_supply.kicad_sch, pressure_sensor.kicad_sch, pulse_counter.kicad_sch, rs485.kicad_sch, solenoid_driver.kicad_sch]
2025-12-11 switch to rt7272b for 24v -> 5v regulator
    [DS18B20.kicad_sch, brineomatic.kicad_pcb, esp32-s3.kicad_sch, power_supply.kicad_sch, pressure_sensor.kicad_sch, pulse_counter.kicad_sch, rs485.kicad_sch, solenoid_driver.kicad_sch]
2025-12-11 switched back to bigger capacitors after reading datasheet
    [brineomatic.kicad_pcb, power_supply.kicad_sch]
2025-12-11 added bootstrap diode just in case
    [DS18B20.kicad_sch, brineomatic.kicad_pcb, esp32-s3.kicad_sch, power_supply.kicad_sch, pressure_sensor.kicad_sch, pulse_counter.kicad_sch, rs485.kicad_sch, solenoid_driver.kicad_sch]
2025-12-11 added bulk cap to 5v rail and tidied silkscreen
    [brineomatic.kicad_pcb, esp32-s3.kicad_sch, power_supply.kicad_sch, pressure_sensor.kicad_sch, pulse_counter.kicad_sch, rs485.kicad_sch, tds.kicad_sch, tmc2209.kicad_sch]
2025-12-11 added a few missing datasheets, switched to new mosfet for buzzer to consolidate bom
    [1115_adc.kicad_sch, brineomatic.kicad_pcb, esp32-s3.kicad_sch, piezo.kicad_sch, power_supply.kicad_sch, solenoid_driver.kicad_sch]
2025-12-11 via stitching redo
    [brineomatic.kicad_pcb]
2025-12-12 switched to bav199 on pressure / tds
    [brineomatic.kicad_pcb, pressure_sensor.kicad_sch, tds.kicad_sch]
2025-12-13 tested and update bom + placement
    [1115_adc.kicad_sch, brineomatic.kicad_pcb, esp32-s3.kicad_sch, piezo.kicad_sch, power_supply.kicad_sch, pressure_sensor.kicad_sch, rs485.kicad_sch, solenoid_driver.kicad_sch]
2025-12-13 silkscreen tweaks for legibility
    [brineomatic.kicad_pcb]
2025-12-13 updated resistor p/ns in bom
    [1115_adc.kicad_sch, DS18B20.kicad_sch, brineomatic.kicad_pcb, brineomatic.kicad_sch, esp32-s3.kicad_sch, piezo.kicad_sch, power_supply.kicad_sch, pressure_sensor.kicad_sch]
2025-12-15 added esd protection to relay driver connector
    [1115_adc.kicad_sch, DS18B20.kicad_sch, brineomatic.kicad_pcb, esp32-s3.kicad_sch, piezo.kicad_sch, power_supply.kicad_sch, pressure_sensor.kicad_sch, pulse_counter.kicad_sch]
2025-12-22 put 2x0 ohm between GND and USB SHIELD
    [DS18B20.kicad_sch, brineomatic.kicad_pcb, brineomatic.kicad_sch, esp32-s3.kicad_sch, rs485.kicad_sch, solenoid_driver.kicad_sch, tds.kicad_sch, tmc2209.kicad_sch]
2025-12-22 add ESD and series resistor to GPIO0/EN
    [DS18B20.kicad_sch, brineomatic.kicad_pcb, esp32-s3.kicad_sch, rs485.kicad_sch, solenoid_driver.kicad_sch, tds.kicad_sch, tmc2209.kicad_sch]
2025-12-22 tmc2209 add 470pF / 100v caps to outputs for esd protection
    [brineomatic.kicad_pcb, esp32-s3.kicad_sch, rs485.kicad_sch, solenoid_driver.kicad_sch, tmc2209.kicad_sch]
2025-12-22 improved stepper 24v routing
    [brineomatic.kicad_pcb]
2025-12-22 updated the modbus schematic with esd and DERE combination
    [brineomatic.kicad_pcb, brineomatic.kicad_sch, rs485.kicad_sch, solenoid_driver.kicad_sch]
2025-12-22 change to 1.5A fuse on usb
    [esp32-s3.kicad_sch]
2025-12-22 L2 -> 3.3v power plane
    [brineomatic.kicad_pcb]
2025-12-22 add inline resistor to temperature sensor + servo inputs - 100ohm
    [1115_adc.kicad_sch, DS18B20.kicad_sch, brineomatic.kicad_pcb, esp32-s3.kicad_sch, piezo.kicad_sch, power_supply.kicad_sch, pressure_sensor.kicad_sch, pulse_counter.kicad_sch]
2025-12-22 switch pulldown to before 220R on mosfets (no voltage divider)
    [brineomatic.kicad_pcb, solenoid_driver.kicad_sch]
2025-12-22 updated analog sensor esd schematic
    [1115_adc.kicad_sch, DS18B20.kicad_sch, brineomatic.kicad_pcb, brineomatic.kicad_sch, esp32-s3.kicad_sch, piezo.kicad_sch, power_supply.kicad_sch, pressure_sensor.kicad_sch]
2025-12-22 added bulk cap after ideal diode
    [1115_adc.kicad_sch, DS18B20.kicad_sch, brineomatic.kicad_pcb, brineomatic.kicad_sch, esp32-s3.kicad_sch, piezo.kicad_sch, power_supply.kicad_sch, pressure_sensor.kicad_sch]
2025-12-22 added more input/output caps
    [brineomatic.kicad_pcb, esp32-s3.kicad_sch, power_supply.kicad_sch, pressure_sensor.kicad_sch, pulse_counter.kicad_sch, rs485.kicad_sch, solenoid_driver.kicad_sch, tds.kicad_sch]
2025-12-22 added 1uF cap to pressure sensor connectors for esd
    [1115_adc.kicad_sch, brineomatic.kicad_pcb, esp32-s3.kicad_sch, power_supply.kicad_sch, pressure_sensor.kicad_sch, pulse_counter.kicad_sch, rs485.kicad_sch, solenoid_driver.kicad_sch]
2025-12-22 voltage divider on EN pin to turn on at 10.2v (EN = 2v) -> connect to VIN not 24v
    [DS18B20.kicad_sch, brineomatic.kicad_pcb, esp32-s3.kicad_sch, power_supply.kicad_sch, pressure_sensor.kicad_sch, pulse_counter.kicad_sch, rs485.kicad_sch, solenoid_driver.kicad_sch]
2025-12-22 5v reg routing
    [brineomatic.kicad_pcb]
2025-12-22 cleaned up hierarchical pin settings
    [DS18B20.kicad_sch, brineomatic.kicad_pcb, brineomatic.kicad_sch, piezo.kicad_sch, pressure_sensor.kicad_sch, pulse_counter.kicad_sch, tds.kicad_sch, tmc2209.kicad_sch]
2025-12-22 tidied up the top level schematic
    [1115_adc.kicad_sch, DS18B20.kicad_sch, brineomatic.kicad_pcb, brineomatic.kicad_sch, esp32-s3.kicad_sch, piezo.kicad_sch, power_supply.kicad_sch, pressure_sensor.kicad_sch]
2025-12-22 holy re-routing batman. board is fully routed first pass.
    [1115_adc.kicad_sch, DS18B20.kicad_sch, brineomatic.kicad_pcb, brineomatic.kicad_sch, esp32-s3.kicad_sch, power_supply.kicad_sch, pressure_sensor.kicad_sch, pulse_counter.kicad_sch]
2025-12-22 a couple placement and routing tweaks
    [brineomatic.kicad_pcb, power_supply.kicad_sch]
2025-12-22 silkscreen fixed, vias stitched, getting close
    [brineomatic.kicad_pcb]
2025-12-23 added test points
    [1115_adc.kicad_sch, DS18B20.kicad_sch, brineomatic.kicad_pcb, esp32-s3.kicad_sch, power_supply.kicad_sch, pressure_sensor.kicad_sch, pulse_counter.kicad_sch, rs485.kicad_sch]
2025-12-23 unsaved schematic
    [brineomatic.kicad_pcb, rs485.kicad_sch]
2025-12-23 changed to tps26630 for power protection
    [power_supply.kicad_sch, tps26630 calculations.ods]
2025-12-23 tps26630 layout is done.
    [brineomatic.kicad_pcb, power_supply.kicad_sch]
2025-12-23 added schottky diode per datasheet
    [brineomatic.kicad_pcb, power_supply.kicad_sch]
2025-12-23 silkscreen updated, drc passing
    [brineomatic.kicad_pcb]
2025-12-23 datasheet double checking - updated RLIM value
    [brineomatic.kicad_pcb, power_supply.kicad_sch, tps26630 calculations.ods]
2025-12-24 removed LC filter and various cleanup for rev c
    [brineomatic.kicad_pcb, esp32-s3.kicad_sch, power_supply.kicad_sch, pressure_sensor.kicad_sch, solenoid_driver.kicad_sch]
2025-12-24 somehow managed to fit the whole ESD/EMI solution into the same stepper footprint.
    [brineomatic.kicad_pcb, tmc2209.kicad_sch]
2025-12-24 fixed silkscreen and vias and all other drc errors.
    [brineomatic.kicad_pcb, power_supply.kicad_sch, rs485.kicad_sch, tmc2209.kicad_sch]
2025-12-24 bom and placement verified
    [1115_adc.kicad_sch, DS18B20.kicad_sch, brineomatic.kicad_pcb, esp32-s3.kicad_sch, power_supply.kicad_sch, pressure_sensor.kicad_sch, pulse_counter.kicad_sch, rs485.kicad_sch]
2025-12-24 cleaned up some vias and ground planes a bit
    [brineomatic.kicad_pcb]
2025-12-24 more power / gnd / via tweaks.
    [brineomatic.kicad_pcb]
2025-12-25 cant believe i deleted the via stitching
    [brineomatic.kicad_pcb]
2025-12-25 minor value tweak and ready for production
    [power_supply.kicad_sch]
2025-12-25 vias off a tiny amount
    [brineomatic.kicad_pcb]
2026-01-06 * Fixed SMAJ5.0A symbols and footprint * Swapped L2 and L3. Now SIG/GND/PWR/SIG * Consolidated both temperature sensors to GPIO4
    [1115_adc.kicad_sch, DS18B20.kicad_sch, brineomatic.kicad_pcb, brineomatic.kicad_sch, esp32-s3.kicad_sch, piezo.kicad_sch, power_supply.kicad_sch, pressure_sensor.kicad_sch]
2026-01-08 Revert "* Fixed SMAJ5.0A symbols and footprint"
    This reverts commit 813d7f7220c8f38d0c15f44e401852de1da31e2a.
    [1115_adc.kicad_sch, DS18B20.kicad_sch, brineomatic.kicad_pcb, brineomatic.kicad_sch, esp32-s3.kicad_sch, piezo.kicad_sch, power_supply.kicad_sch, pressure_sensor.kicad_sch]
2026-01-08 Fixed SMAJ5.0A symbols and footprint
    [brineomatic.kicad_pcb, brineomatic.kicad_sch, servo.kicad_sch]
2026-01-08 Swapped L2 and L3. Now SIG/GND/PWR/SIG
    [1115_adc.kicad_sch, DS18B20.kicad_sch, brineomatic.kicad_pcb, brineomatic.kicad_sch, esp32-s3.kicad_sch, piezo.kicad_sch, power_supply.kicad_sch, pressure_sensor.kicad_sch]
2026-01-08 Fixed Water/Motor Temperature silkscreen mixup
    [brineomatic.kicad_pcb, brineomatic.kicad_sch]
2026-01-08 fixed a rename mistake between temp sensor signals
    [brineomatic.kicad_sch]
2026-01-08 Re-routed 5V to run through TVS first
    [brineomatic.kicad_pcb]
2026-01-09 updated silkcreen with REV_C1
    [brineomatic.kicad_pcb]
2026-01-09 increased amperage on F2 / 5v
    [brineomatic.kicad_pcb, power_supply.kicad_sch]
2026-01-12 added lcsc p/n for fuse.
    [power_supply.kicad_sch]
2026-03-03 added rev c case
2026-03-22 Marked R67 (RS485 termination resistor) as DNP
    [brineomatic.kicad_pcb, rs485.kicad_sch]
2026-03-25 added schematic and pcba instructions
2026-05-07 bus voltage now.
2026-06-02 Updating schematic for Rev D: * Original ADS1115 * brine tds (same) * product tds (same) * bus voltage (new) * spare 4-20ma sensor (new)
    * Add 2nd ADS1115 -> only 4-20ma sensors
    * pre-filter pressure - jst 2.0
    * mid-filter pressure - jst 2.0
    * post-filter pressure - jst 2.0
    * high pressure - jst 2.0
    * alert pin -> gpio3
    [1115_adc.kicad_sch, DS18B20.kicad_sch, brineomatic.kicad_sch, bus_voltage.kicad_sch, esp32-s3.kicad_sch, piezo.kicad_sch, power_supply.kicad_sch, pressure_sensor.kicad_sch]
2026-06-15 tds sensor input -> pin header 2.54 3x03
2026-06-15 removed fiducials + alignment holes
2026-06-15 * added 30ma PTC fuses to 24v line of pressure sensors * new part layout mostly done
