hoeken/brineomatic/(notices)

Notices in the files:
brineomatic/tmc2209.kicad_sch:
Released under the Creative Commons Attribution Share-Alike
License. http://creativecommons.org/licenses/by-sa/4.0
